BennJo101/Gene_1.0/docs/DESIGN_NOTES.md

> Design notes and history for the Gene head, kept as written while it was designed. File names refer to the
> model sources in `cad/` and scripts in `cad/tools/`; print-ready files are in `print/`. Parts marked retired or
> superseded are described for history only and are not included in this repo.

# Gene head - current build (start here)

Updated 2026-09-25. This section is the current state of the design. The
sections below it are the design history in the order it was built; where a
part or number there has since changed, it is marked **Superseded**.

All dimensions mm. Head frame: jaw pivot axis = X, origin on the axis, -Y is the
front (the face), +Z up. The robot faces -Y, so its own left is +X.

## What to print

Everything is in `print/`, oriented and laid out on six plates (each fits
250 x 250). `BOM.md` / `BOM.csv` have the full parts, hardware and electronics list.

| Part | Source file | Qty |
|---|---|---|
| Skull v7 | `skull.stl` (built by `tools/skull_v7.py` from v6) | 1 |
| Jaw v5, hex pockets + bores for the screw-in pins | `jaw.stl` (built by `tools/jaw_screw_pins.py`) | 1 |
| Jaw pivot pin (hex head, bearing pin, D-shaft) | `jaw_pin.stl` | 2 |
| Servo brackets v2 (with battery pads) | `servo_bracket_L.stl`, `servo_bracket_R.stl` | 1 + 1 |
| Jaw drive hub | `jaw_drive_hub.stl` | 2 |
| Eye display carrier v3 (wide top + bottom slots) / retainer | `eye_display_carrier.stl`, `eye_display_retainer.stl` | 2 + 2 |
| Camera bezel (black) / pupil ring (black) | `camera_bezel.stl`, `pupil_ring.stl` | 2 + 2 |
| Pi 5 shelf v6 | `pi_shelf.stl` | 1 |
| Battery tray / deck | `battery_tray.stl`, `battery_deck.stl` | 1 + 1 |
| Crown insert | `crown_insert.stl` | 1 |
| Bridge handle (optional) | `bridge_handle.stl` | 1 |
| GPIO flashlight (optional, instead of the handle) | `gpio_flashlight.stl` | 1 |
| GPIO cover (optional, for when nothing is plugged in) | `gpio_cover.stl` | 1 |
| Neck / neck base / clamp collar | `neck.stl`, `neck_base.stl`, `neck_collar.stl` | 1 each |

Retired, do not print: `GeneTop_v6_neck` (v7 is v6 + clearances), `GeneTop_v3_*`, `GeneTop_v4_camslots`, `GeneTop_v5_crownbay`,
`GeneBottom_v3_jawdrive`, `GeneHead_xl330_bracket(_R).stl` (v1), `GeneHead_pi_shelf_v4/v5`,
`GeneHead_top_handle.stl` (twist-lock), `GeneTop_v3_barrel_*` (the barrels are in the skull).

## Limits to set in software

| | |
|---|---|
| Jaw speaking range | 0 - 30 deg |
| Jaw servo limit, **neck fitted** | **33 deg** (chin reaches the neck base at 35.5) |
| Jaw servo limit, no neck | 50 deg (first skull contact at 53.25) |
| Twin XL330s | one of the pair **reversed** (Drive Mode bit or negated angle) |
| Neck rotation | no stop (slip ring) |
| Pi 5 on GPIO 5 V | `usb_max_current_enable=1` in `config.txt` |
| Jaw flapping speed, on the neck | up to ~4.4 swings/s of 0-20-0 deg stays within 80 % of servo torque |
| Jaw flapping speed, **head standing on its jaw** (no neck) | **under ~3 swings/s** of 0-20-0 deg; 4/s needs 107 % |
| Talking mouth opening, on the neck | **53 %** of full visemes (~12 deg on "ah", 14 max): servos never max out, 20 % reserve. Yelled ("!") x1.6 -> ~20 deg, brief strain OK |
| Talking mouth opening, head on its jaw | **28 %** (~6 deg on "ah", 7 max), same criterion. Yelled -> ~11 deg at 95 % of available torque |

Weight and servo load (estimate, `tools/mass.py` -> `tools/web/mass.json`, 2026-10-30):
about 1316 g / 2.9 lb as the sim shows it (flashlight, no handle, no neck); skull side
1035 g, jaw + hubs + pins 281 g. Skull CoM 40 mm in front of the pivot and 9 mm above it; jaw
CoM 77 mm in front and 72 mm below. Holding torque against the pair's 1.04 N.m stall:
on the neck 0.21 N.m (20 %) with the jaw shut; standing on the jaw, 0.40 N.m (39 %) just
off closed, easing to 0.19 N.m at 50 deg. Printed parts are estimated from volume + area at
the BOM settings and bought parts from typical weights, so expect +/-15 %: weigh the real head
and rerun. Printing the jaw with 2 walls / 15 % instead of 4 / 22 % cuts it from ~261 to ~162 g.

## Assembly order

1. Eyes: glue the display carriers into the barrels from inside (they are a slip
   fit), fit the displays, glue the retainers behind them (rest each retainer on the LCD, don't press it, or the screen shows pressure marks).
2. Cameras: fit each camera into its black bezel, press the ribbon into the
   slit on the back of the bezel's spoke (no threading - the camera stays on
   its cable) and through the barrel's inboard slot, push the bezel onto the ridge,
   and glue a black pupil ring round the lens. The right bezel is the left one
   turned 180 deg.
3. Battery unit on the bench: pack in the tray (2 straps), deck on (4 x M3x10),
   bucks, BMS and charger on the deck. Lift the whole unit straight up through the
   open bottom of the skull into the dome.
4. Drive: servos onto the v2 brackets (4 x M2x8 each), brackets onto the skull
   walls (2 x M3x16 each, then 2 x M2x16 hex bolts each in from outside the skull,
   M2 nut in the foot's hex pocket). Lower the tray onto the bracket pads, 4 x M3x12 up
   through the pads.
5. Pi: GPIO ribbon's female end onto the header, Pi onto the v6 shelf with the
   header along the front edge (4 x M2.5x12 + nuts). Route the ribbon up in front
   of the battery tray. Drop an M2 nut into the slot in each of the shelf's 4 cubes, push the shelf up into the skull with the cubes in the divots until they stop, then 4 x M2x12 hex bolts in from outside the skull.
6. Crown: push the ribbon's male plug up into the crown insert's pocket, drop the
   insert into the slot, 4 x M2x12 hex bolts. With the handle: bridge handle on
   top, 4 x M3x16 socket heads instead.
   Optional, after the crown: either press the GPIO cover into the well (notch to the
   rear), or fit the GPIO flashlight (see *GPIO flashlight and GPIO cover* below).
7. Jaw: slide the bare jaw up from below so the arm bores line up with the skull
   sockets (no flexing the arms). Push each pin (printed in PETG or tougher) in from outside, D-shaft first,
   through the arm and the socket until the hex head seats flush in the arm's hex
   pocket. Hubs onto the D-shafts (grub screws), hubs bolted to the horns (4 x M2x12
   each), then an M3x5 grub screw into the back edge of each arm to lock its pin.
8. Neck: yoke up under the rear rim, 5 x M3x16. Feed the slip ring's rotating
   wires up the tube bore. Bearings into the base, tube into the bearings, collar
   on underneath (M3 set screw), slip ring onto the base floor (3 x M3x8). Base to
   the body with 4 x M4.

## Still open

- Power switch hole in the skull (the USB-C charge port is cut).
- Wiring for the power switch once its hole exists.
- A drive for the neck rotation, and the body/stand the neck base bolts to.
- Assumed sizes to check against real parts: 2.1" round LCDs, eye cameras,
  speakers, the GPIO ribbon's male plug, the slip ring.

## Verified (last full check)

41 parts assembled, 129 neighbouring pairs measured, 15 cable runs routed and checked with exact solid
intersection; no overlaps except seating contacts. The jaw swept 0-60 deg in
0.25-0.5 deg steps against every part. All print files are single watertight
solids on reload.

Interactive sim with every part, the jaw sweep, head turn, eye expressions and
the two camera views: `sim/head_sim.html` (open it in a browser)

---

## v7 skull and v3 camera bezel - sized to the parts bought (2026-10-04)

Built from the Amazon order of 2026-09-30. Scripts: `tools/skull_v7.py`, `tools/cam3_arducam.py`, check with `tools/check_v7.py`.

| Part bought | Real size | Change |
|---|---|---|
| Arducam B0066 mini OV5647 | 8.5 mm head, ~12 mm with the crystal; 6.0 mm flex; rigid 16 x 30 mm 15-pin tail | Barrel ribbon slots 14 x 4 -> **26.5 x 7.5** (Y -114..-87.5, Z +/-3.75). Bezel pocket 8.6 x 8.6 -> **8.6 x 12.4** (grows towards the cable only, lens stays on axis); 3.6 mm mid-depth tunnel -> **6.8 x 2.2 lane from the rear face**, level with the camera board, 5.6 mm lipped mouth from r=16; spoke 7.0 -> 11.5 |
| TekGroAml 2.1" LCD + driver | LCD 56.18 x 59.71 x 2.3, 26.9 mm flex down; **round 57 mm board**, mini-HDMI + micro-USB on the edge opposite the flex | Top window in each barrel mirroring the bottom one (+/-37.5 deg, Y -96 to the barrel end) and a pocket in the skull above it from Y -88 back, up to 54 mm from the eye axis, never closer than 3 mm to the outside (measured min **3.45 mm**) |

Free height above the board's top edge went from ~2 mm to 17-29 mm over the middle of the eye at Y -84,
and 16-40 mm from Y -76 back. The exception is the **outboard** side (more than ~8 mm out from the eye
axis, in front of Y -76), where the barrel itself is the outside of the head: that's still ~2 mm. So mount
each driver board far enough back (PCB front face at Y -73 or further, about 19 mm behind the back of the LCD - checked with `mocks/display_driver_board.stl`, 0 overlap) that the
outboard plug clears; the LCD flex is long enough to run straight back rather than folding. With the
flex at the bottom and the board's parts facing back, the HDMI plug sits 6 mm outboard of the axis on the
left eye and the USB 9 mm outboard on the right.

Verified: skull single watertight solid (589.9 cm3); bezels, cameras, carriers, displays, retainers, pupil
rings, shelf, Pi, battery unit, brackets, servos, speakers, amps, TTL vs v7: 0 overlap (insert 7.4 mm3 and
neck 1.4 mm3 are the same seating contacts as v6).

Still assumed: display MOCK is still the old 55.4 x 5.2 shape (the real LCD is thinner, so the retainer
sits ~2.9 mm further forward - it's glued, so that's fine). Note the real LCD is 56.18 +/- 0.15 against the
56.00 display seat - test-fit and ease the seat if it's tight. **Eased to 56.60 on 2026-10-30** (see *Display carrier seat eased*).

**Display carrier v2** (`tools/carrier_topslot.py`): still a separate glued-in cup (the barrels are part of the skull, the carriers are not). It gains a flex slot at the top matching the bottom one (+/-15.75 deg, Y -92.5 to the back face), for the driver board's HDMI/USB side. Original carrier kept as `tools/retired/carrier_v1_before_topslot.stl`.

**Display carrier v3** (same script): both slots widened to +/-74.25 deg (Y -92.55 to the back face), so behind the front lip only two side walls are left, each 31.5 deg wide (the width of the old v2 slot). The front lip ring is untouched and still frames the display. Volume 2.45 cm3, down from 4.7. The retainer now has only the two side walls to glue to. v2 kept as `tools/retired/carrier_v2_before_wide_slots.stl`.

**Display carrier seat eased (2026-10-30)** (`tools/carrier_ease_seat.py`): the screens showed slight pressure marks. The real LCD is 56.18 +/- 0.15 across and the seat was 56.00, so the carrier squeezed the glass round its edge, more so as printed holes come out a little undersize. The seat is now **56.60** from the lip's rear face (Y -94.1) to the back face: 0.21 mm a side on a nominal panel, 0.13 on the largest. The front lip (aperture 53.80, so the panel still overlaps it by 1.2 mm a side) and the OD 60.50 are unchanged, so the screen is framed the same and the carrier still slips into the barrel. Side walls 2.25 -> 1.95 mm, 2.28 cm3. The retainer (OD 55.80) still drops in. When gluing the retainer, rest it on the back of the LCD without pressing: it only has to stop the panel falling back. **The glass is not round** (Tailor Pixels TTC021XRS-02 drawing, the same 56.18 x 59.71 x 2.3 panel): a R28.09 circle plus a flat-ended ledge on the flex side, 31.40 wide, its flat edge 31.62 from the centre. The carrier's top and bottom slots started at Y -92.55, so for the first 1.55 mm of the glass the ledge hit a full ring of wall and the panel couldn't sit flat on the lip. Both slots now run forward to the lip's rear face (Y -94.1), 1.83 cm3. The skull's barrels were also in the way: see *Skull v7 ledge relief*. All behind the lip, so the eyes look the same from outside. `print/parts/09_eye_display_carrier_x2.stl`, Plate 4 and Plate 10 (just the two carriers) regenerated; previous carrier kept as `tools/retired/carrier_v3_before_seat_ease.stl`.

**Skull v7 eye pockets made symmetric (2026-10-06)** (`tools/skull_v7_mirror_eye.py`, run after `skull_v7.py`): the plug pocket above Gene's right eye (-X) had a ragged outboard edge, because v6 has leftover internal weld faces at that barrel/skull crease that confused the skin check. The -X eye region (X -100..-33, Y -109..-49, Z 20..75) is now the exact mirror of the clean +X (left) eye. Still one watertight solid (589.5 cm3), min skin 3.34 mm (right) / 3.41 mm (left), part overlaps unchanged (only the insert/neck/handle seating contacts). The +X side is untouched. Old file kept as `tools/retired/GeneTop_v7_before_eye_mirror.stl`. `print/skull_x1.stl`, `3D print/01_skull_x1.stl`, Plates 1 and 9 and the sim have been regenerated.

**Skull v7 barrel corners sealed (2026-10-06)** (`tools/skull_v7_seal_corners.py`, run after `skull_v7_mirror_eye.py`): the bottom flex window cut through the barrel wall where the lower side wall meets it, leaving a small triangular hole to the outside at the outboard bottom corner of each eye (Y -96 to about -85). The barrel wall is restored there only outboard of the lower wall's inner face (r 83.5 about X 0, Y -48), so the inside of the window is unchanged. +1.39 cm3 (590.9 cm3), one watertight solid, part overlaps and the 0-60 deg jaw sweep unchanged. Previous file kept as `tools/retired/GeneTop_v7_before_corner_seal.stl`.

**Skull v7 barrel ends blended into the skull (2026-10-06)** (`tools/skull_v7_barrel_taper.py`, run after `skull_v7_seal_corners.py`): each eye barrel ended in a flat face at Y -61.5 standing up to 4.5 mm proud of the skull side, with a thin see-through crack along it. The barrel's outer cylinder (r 34.25) now carries on backwards as a cone (0.35 mm radius per mm, about 19 deg) that runs into the skull side, which closes the crack. The cone is trimmed outside the head cavity (r 83.3), outside the bore and out of the top +/-45 deg where the plug pocket is, so nothing changes inside. +2.07 cm3 (592.9 cm3), one watertight solid, part overlaps and the 0-60 deg jaw sweep unchanged. Previous file kept as `tools/retired/GeneTop_v7_before_barrel_taper.stl`.

**Skull v7 inboard barrel walls opened (2026-10-06)** (`tools/skull_v7_open_inboard.py`, run after `skull_v7_barrel_taper.py`): the real TekGroAml driver board (seller's drawing: 57 mm round, 4 x M2.5 at (0,0) (0,33.4) (35,33.4) (38.69,0), mini-HDMI 11.5 wide at (-9.27,22.6) and micro-USB 8.0 wide at (-9.37,7.83), both angled 15 deg and splaying apart, 40-pin FPC connector 26.8 long on the opposite edge) puts the outboard plug of each eye - mini-HDMI on Gene's right, micro-USB on his left - only 8-10 mm from the barrel skin when mounted flex-down. The plan is to turn each LCD + board 180 deg in its barrel (flex up, plugs down; the Pi flips the picture with a standard 180 deg display rotation). To let the LCD ribbon swing past while turning it, the inboard wall of each barrel is removed from the top of the camera ribbon slot (Z +3.43) up to the top window, Y -96 to the barrel end, barrel wall only (r 29.8..34.4); beyond it is open head cavity. The bridge between the eyes and the outboard walls are untouched. -7.6 cm3 (585.4 cm3), one watertight solid. With the boards flipped (mock rotated 180 deg) there is no overlap with the skull, Pi shelf, speakers or anything else; the inboard plug then has about 11-12 mm to the Pi shelf's top plate, the outboard one 12-17 mm to the lower side wall. Previous file kept as `tools/retired/GeneTop_v7_before_open_inboard.stl`.

**Skull v7 USB-C charge port (2026-10-06)** (`tools/skull_v7_usbc_port.py`, run after `skull_v7_open_inboard.py`): the charge port is a Poyiccot USB-C panel-mount extension (B086W2R8Z6): female end with a 25 x 8 flange, 2 x M3 holes 16.6 apart, 34.5 long overall; 30 cm lead to a right-angle male that plugs into the charger board on the deck. It is centred on the back of the head at X 0, Z -14, in the vertical-cylinder part of the wall (r 84.0..91.6 about X 0, Y -48). The flange runs vertical, so it seats along the straight direction of the wall and needs no curved seat. Cuts: a flat seat pocket 8.6 x 25.6 from the inside, leaving 3.0 mm of wall in front of the flange (seat plane Y 40.63); a 7.6 x 13.8 (r 2.5) opening through it, big enough for a max-size USB-C overmold (6.5 x 12.35); and 2 x dia 3.4 M3 holes at Z -14 +/- 8.3, which the opening runs 0.3 mm into (a hairline web there would not print). Fit the flange from inside, then the 2 x M3 from outside into its threads; with the supplied 11 mm screws, 8 mm reaches into the flange. Checks: the yoke screw pilots end at Z -41, 14 mm below the flange; with the connector body modelled straight into the head (`mocks/usbc_panel.stl`: flange 4 thick and body 6.5 x 12 x 18 assumed), it clears every part, the jaw sweep and every routed cable by >= 1.6 mm (Pi buck lead) and seats on the skull with 0 overlap. -1.37 cm3 (584.0 cm3), one watertight solid. `print/parts/01_skull_x1.stl`, Plates 1 and 9 and the sim have been regenerated. Previous file kept as `tools/retired/GeneTop_v7_before_usbc_port.stl`.

**USB-C charge port turned 90 deg (2026-10-08)** (`tools/skull_v7_usbc_port.py` edited, then steps 7 and 8 rerun): the flange's long axis now runs horizontal (along X) instead of vertical, so the 2 x M3 holes sit side by side at X +/-8.3, Z -14, and the opening is 13.8 wide x 7.6 tall. Same centre (X 0, Z -14) and seat plane (Y 40.63). The flat seat now spans 25.6 mm across the curved wall, so the wall in front of the flange is 3.0 mm at the centre, 2.6-2.7 at the screws and 2.1 at the flange ends. Mock turned to match (body 12 x 6.5): 0 overlap with the skull, 7.1 mm to the Pi, clear of the jaw sweep, nearest routed cables 1.76 mm (camera L ribbon) and 1.90 mm (Pi buck lead).

**Superseded 2026-10-16 by the shelf divots below.** **Skull v7 shelf nut posts (2026-10-08)** (`tools/skull_v7_shelf_posts.py`, run after `motor_mount_m2.py`): the Pi shelf's 4 wing holes (dia 2.5 at X +/-62, Y -49 / -21, vertical) opened onto empty cavity, because the wall is 17-22 mm outboard of them, so the M3 self-tappers had nothing to screw into. The skull now has a post above each hole: a block 11 wide (Y) x 6 tall (Z -37..-31) whose flat underside is the wing's top face, running from 5.5 mm inboard of the hole out into the wall (inner wall r 83.7 about X 0, Y -48; the post is fused in up to r 86, and the outer skin at r 91.4 is untouched). Each post has a dia 2.4 hole on the wing hole's axis and a 4.3 AF x 2.0 hex slot (Z -35..-33) open to its inboard face, for an M2 nut slid in sideways. An M2 x 8 socket head goes up from under the wing; the head-to-nut-top grip is 6.6 mm, leaving 1.4 mm past the nut. The wings are unchanged. The TTL interface now rests on the two left post tops (mock raised 6 mm, Z -30.9..-16.3; nearest part the left bracket at 4.6 mm). Checks: nuts 0 overlap with the skull, bolts clear of the skull and shelf, skull overlaps with every part unchanged, jaw and hubs never within 9 mm of the bolt heads over 0-60 deg. The post undersides overhang inside the head, so the skull still needs tree supports there. +6.3 cm3 (589.8 cm3), one watertight solid. `print/parts/01_skull_x1.stl`, Plates 1 and 9 and the sim have been regenerated.

**Skull v7 shelf divots and bracket M3 pilots (2026-10-16)** (`tools/skull_v7_shelf_divots.py` replaces `skull_v7_shelf_posts.py`; pilots added to `tools/motor_mount_m2.py`): the whole shelf drops 13.35 mm so its plate's underside is flush with the skull's bottom rim (Z -53.35; plate Z -53.35..-50.35), which gives the Pi 13.35 mm more headroom (Pi stack top Z -28.75, ~43 mm under the battery tray). The speaker cradles hang 7 mm below the rim (Z -60.35), the two 'buck teeth'; the jaw stays >= 7.7 mm from them over 0-60 deg. The Pi, speaker, amp, TTL and splitter mocks moved down with it (`gpio_mocks.py` SHELF_DROP, `route.py` endpoints). The 4 nut posts come off the skull and move onto the shelf as cubes, fused to the top of each wing (Z -50.35..-44.35, 11 wide round the old wing hole, from 5.5 mm inboard of it out to r 85.95 about X 0, Y -48, i.e. 2.25 mm into the wall; the old wing holes are filled). Each cube slides up into a divot: a groove in the inner wall, 11.6 wide and 2.5 deep (out to r 86.2), open at the bottom rim (Z -53.35) and roofed 0.2 above the cube top. The roof is the stop that sets the shelf height. A 4.3 counterbore from outside (head flush with or just under the skin) and a dia 2.4 clearance run along X at Z -47.35 through the wall into the cube, onto an M2 nut dropped into a slot in the cube's top 3 mm inboard of the wall (flats top and bottom, so it seats on the slot floor on the bolt axis). Head to nut far face 9.7-10.0 mm: **M2 x 12**. Wall left behind each groove 5.2 mm, 2.5-2.9 mm under the counterbores. The posts were removed by cutting their footprint back to the wall's own section at Z -38 (the wall is vertical there; the wall line over Z -38..-30 then matches to 0.03 mm, and the volume returns to the pre-post 583.5 cm3). The skull never had the pilots for the bracket M3 self-tappers (nor did v6); they are now cut too: dia 2.5 along X at Y 20, Z +/-10, from the bracket foot face to 2 mm under the skin, 9.9-10.3 mm into the wall. Checks: the shelf with the Pi, speakers, amp, TTL interface and GPIO splitter on it slides the full 38.8 mm up from fully below the rim to its seat touching nothing (0.5 mm steps, against the skull and everything fitted in steps 1-4); seated, it only touches the skull (cube tops on the divot roofs) and the neck yoke's top face, flush with the plate's underside (0 overlap); skull overlaps with other parts unchanged (insert, neck and handle seating contacts). Skull 582.1 cm3, shelf 48.8 cm3, both one watertight solid. `print/plates/Plate8_changes_2026-10-16.3mf` has the skull, shelf and eye X insert together (267 x 301 mm, for the K2 Plus's 350 mm bed). `print/parts/01`, `03` and Plates 1 and 3 regenerated.

**Skull v7 plate between the eyes cut to a U (2026-10-30)** (`tools/skull_v7_eye_plate_window.py`, run after `skull_v7_shelf_divots.py`): the flat plate joining the inboard walls of the eye barrels (Z 2.5..5.1, 2.6 mm thick, X -27..27, Y -130..-82, 5.8 cm3) carries nothing, and printed rim-down it is a roof 57 mm above the bed with tree supports under all of it. Its middle is now cut out through the free back edge (X -20.3..20.3, Y -123.5 to the back, R 5 corners at the face), leaving a U: a 6 mm strip along each barrel wall and one along the face, so the plate still ties the barrels to each other through the face. There is no bar across the back, which would span 54 mm in the air. -4.12 cm3 (577.9 cm3), one watertight solid; part overlaps unchanged (only the insert/neck/handle seating contacts). A first voxel FEA of the skull front (2 mm grid, fixed at Y -30, 20 N on each barrel's front rim down, inward, backward, and on one barrel only) moved the rims within 4 % with the whole plate removed, so the U keeps more than it needs. The camera ribbons still leave the barrels at Z 0 under the side strips. `print/parts/01_skull_x1.stl`, Plates 1 and 8 and their tree-support copies regenerated. Previous file kept as `tools/retired/GeneTop_v7_before_eye_plate_window.stl`.

**Skull v7 barrel tabs shortened (2026-10-30)** (`tools/skull_v7_shorten_tabs.py`, run after `skull_v7_eye_plate_window.py`): behind the camera ribbon slot (rear edge Y -87.5) each barrel's inboard wall is only a lower arc, from the slot's height down to about Z -25, left over from opening the inboard walls. It ran back to the barrel end at Y -61.4 and carries nothing behind the display carrier (which ends at Y -84.1). Both tabs are now cut back to half that length, ending at Y -74.45 (13 mm behind the slot, 9.6 mm behind the carrier). Only the inboard half of the barrel wall is cut. -3.27 cm3 (574.7 cm3), one watertight solid; part overlaps unchanged. `print/parts/01_skull_x1.stl`, Plates 1 and 8 and their tree-support copies regenerated. Previous file kept as `tools/retired/GeneTop_v7_before_shorten_tabs.stl`.

**Skull v7 ledge relief (2026-10-30)** (`tools/skull_v7_ledge_relief.py`, run after `skull_v7_shorten_tabs.py`): mounted ribbon up, the LCD's ledge sits at Y -94.1..-91.8 and spans +/-34 deg about the top of the barrel, where the outboard barrel wall (bore r 30.3, outside r 34.4) was solid. On that side the barrel's outside *is* the head's skin, and with a plain rectangle for the ledge its corners reach r 35.3, outside the skin, so a full-depth clearance can't be cut (a first attempt opened the skin above both barrels and was reverted). The ledge outline +0.4 is cut into the wall only out to r 33.2, from Y -94.5 to the barrel end, leaving about 1.1 mm of wall under the skin (measured 1.02-1.05 on rays from the relief face). Checked from outside with rays from 13 directions: no change at all. The rectangle outline still overlaps that last wall by 10.7 mm3 per eye (was 86), at its corners; the real ledge is rounder (the screens went in ribbon-up), so it should now sit free. Turning the screens to clear it was ruled out: with the driver board turned with them by 30-50 deg the board and plugs hit the skull by 380-600 mm3, and the 26.9 mm flex can't reach a board left where it is. -0.67 cm3 (574.0 cm3), one watertight solid; part overlaps unchanged. `print/parts/01_skull_x1.stl`, Plates 1 and 8 and their tree-support copies regenerated. Previous file kept as `tools/retired/GeneTop_v7_before_ledge_relief.stl`.

**Eye X insert (2026-10-16, optional)** (`tools/eye_x_insert.py`): a Halloween cap for an eye barrel. A solid dia 58.70 x 6 plug goes into the dia 59.00 front bore (the bezel is 38 mm further in), a dia 66 x 2 flange (0.8 chamfer) sits on the barrel's front face at Y -137.6, inside the barrel's 68.5 outline, and a raised X stands 3 mm proud: two 52 x 8 round-ended bars at +/-45 deg. Symmetric, so it fits either eye; 0 overlap with the skull in both, seated on the face. 25.2 cm3, 11 mm tall printed plug down. `cad/eye_x_insert.stl` (barrel frame) and `print/parts/20_eye_x_insert_OPTIONAL_x1.stl`. Not on a plate.

**Servo brackets through-bolted with M2 (2026-10-06)** (`tools/motor_mount_m2.py`, run after `skull_v7_usbc_port.py`): each bracket's foot (its rear end, cut conformal to the inside of the skull wall, inner face the plane X -/+43) now also takes 2 x M2 socket-head bolts through the skull wall, alongside the 2 x M3 self-tappers (Y +20, Z +/-10). Bolts at Y 19, Z +/-4.5, along X like the M3s: dia 2.4 clearance through the wall and foot, a dia 4.3 counterbore from outside whose floor sits 2.2 mm under the shallowest point of the skin round it (so the 2.0 mm head ends up flush or just under the skin; the skin is slanted there, so the counterbore is up to ~3 mm deep on its forward side), and a 4.3 AF x 2.2 hex pocket in the foot's inner face for an M2 nut. Grip from the head to the far face of the seated nut is 13.8-14.3 mm, so **M2 x 16** leaves ~2 mm past the nut, ending 1-1.5 mm inboard of the foot face (open space; the servos end at Y 9.5). The foot is 7.6 mm thick at the bolts, leaving 5.4 mm behind each nut; nut corners are 1.5 mm from the M3 holes. Skull 583.6 cm3, brackets 6.84 cm3 each, all single watertight solids; the assembly check shows no new overlaps and the bracket gaps are unchanged. `print/parts/01`, `06`, `07`, Plates 1, 4 and 9 and the sim have been regenerated. Previous files kept as `tools/retired/GeneTop_v7_before_m2_bolts.stl` and `GeneHead_xl330_bracket(_R)_v2_before_m2_bolts.stl`.

**Jaw pivot-screw holes filled (2026-10-06)** (`tools/jaw_fill_pivot_holes.py`): each jaw arm had a stepped blind hole on the pivot axis, opening on the outboard face (dia ~5.4 for 14 mm, then dia ~2.9 down to the start of the D-shaft, 30.4 mm deep in all). It was for a screw through the pivot. The pins are now D-shafts clamped by the drive hubs and nothing screws into the jaw, so both holes are filled solid, flush with the arm faces. +0.81 cm3 (408.3 cm3), one watertight solid, outer shape and bounds unchanged, so fits and the jaw sweep are unaffected. `print/parts/02_jaw_x1.stl`, Plate 2 and the sim have been regenerated. Previous file kept as `tools/retired/GeneBottom_v4_before_hole_fill.stl`.

**Jaw v5: screw-in pivot pins (2026-10-29)** (`tools/jaw_screw_pins.py`): on v4 each arm carried its dia 13.74 bearing pin and dia 8 D-shaft as one piece, 42 mm out from the arm's inner face, and the pin had to pass axially through the closed ring of the skull socket (full circle over X -/+78..73). Fitting the jaw meant springing the arms ~32 mm apart each side, and the pins snapped. The pins are now separate parts, `jaw_pin.stl` x 2 (the right one is the left turned 180 deg about Z, as with the hubs):
- **Pin:** hex head AF 15 x 5.9, then the v4 bearing pin (dia 13.74) and D-shaft (dia 8, flat at Z +3, ends at X -/+46), taken from the v4 mesh unchanged inboard of X -/+78. 53 mm long, 5.5 cm3. Print hex head down, 100 % infill, in a tough filament: PETG at least, nylon (PA / PA-CF) or PC if your printer can do it, not PLA.
- **Arm:** hex pocket AF 15.3 x 6.0 deep in the outboard face (0.15 clearance per flat; 2.0 mm of wall left at the pocket corners, the arm face is r >= 10.9 round the axis), then a dia 14.1 bore through the rest of the arm. The step under the head seats on the pocket floor, so the pin is located inboard; the hex carries the servo torque into the jaw.
- **Lock:** an M3 x 5 grub screw (the hub size), radial along +Y from the back edge of each arm, 3 mm in from the outboard face, into a 3.2 wide groove round the hex head (root r 5.8, so the grub ends flush with the arm edge). The line is clear of every other part for a hex key.
- **Assembly:** without the pins, the jaw slides straight up onto the skull from below with no contact at any point of the path (checked by translating it 0-25 mm in 30 deg steps round the axis: straight down and 30 deg behind it are both clear). Then each pin goes in from outside, through the arm and the socket into the hub.

Checked: jaw 396.45 cm3 and pins single watertight solids (also on reload); pin-to-jaw gap 0.05 (L) / 0.10 (R) mm, pin-to-socket 0.37 mm, the same running fit as v4. Every other contact in the static check is unchanged (the D-shaft-to-hub and horn contacts have moved from the jaw to the pins), and so is the sweep: first skull contact 53.25 deg, neck base 35.5 deg. `print/parts/02_jaw_x1.stl`, the new `23_jaw_pin_x2.stl`, Plate 2 (jaw + 2 pins, 198 x 186 mm) and both sims have been regenerated. Previous jaw kept as `tools/retired/jaw_v4_before_screw_pins.stl`.

---

# Design history

## Jaw drive (XL330-M288-T), first version

**Superseded:** this section describes the single-servo v3 drive. The build now uses
the twin drive (jaw v4, v2 brackets) - see *Twin motors* and the current build above.

All dimensions mm. Reference frame: pivot axis = X, origin on the axis,
+X inboard (toward head centre), left side is -X. The drive is on the LEFT.
Jaw rest angle = 0 deg in this frame.

## Parts

| File | What | Print |
|---|---|---|
| `GeneBottom_v3_jawdrive.stl` | The jaw, with the left pivot pin extended into a dia 8.0 D-shaft | 1 |
| `jaw_drive_hub.stl` | Drive hub: dia 18 OD x 15 long, D-bore, 4 x M2 on dia 12 to the horn, radial M3 grub | 1 |
| `GeneHead_xl330_bracket.stl` | Servo bracket, 4 x M2 to the servo, 2 x M3 into the skull wall | 1 |
| `GeneTop_v3_thrustpad.stl` | The skull, with a conformal thrust pad added at each pivot | 1 |
| `GeneHead_jawdrive_assembly.stl` | Whole thing assembled, for viewing only | - |
| `render_jaw_drive.png` | Hub, bracket, and the drive train | - |

Hardware: 4 x M2 x 12 (hub to horn), 4 x M2 x 8 (servo to bracket),
2 x M3 x 16 self-tapping (bracket to skull), 1 x M3 grub (hub to shaft).

## How it goes together

1. Jaw pin passes outside-in through the skull socket as before. The new
   dia 8.0 D-shaft continues past the socket into the head.
2. Hub slides onto the D-shaft, flat-to-flat, grub screw from the side.
3. Servo bolts to the bracket (4 x M2), horn facing outboard.
4. Bracket screws to the skull's inner wall (2 x M3 at Y=+20, Z=+/-10).
   The bracket foot was cut with a boolean against the skull, so it is an
   exact conformal match to the inner surface, not a flat pad on a sphere.
5. Hub bolts to the horn, 4 x M2 on the dia 12 bolt circle.

## Verified numerically

- Every part watertight and a single body.
- Zero interference: hub/servo/jaw vs skull and bracket, 0 of 8000 sample
  points in all six pairings.
- Bracket vs skull max penetration 0.0000 mm (conformal by construction).
- Bracket screws pass through 8 mm of bracket into 11 mm of skull wall
  (wall measures 7.5-11 mm thick all round the pivot).
- Jaw sweep clear 0-53 deg; first contact (left arm) at 53.25 deg, right arm at 57.25 deg.
  Set the servo limit to 50 deg or less - **or 33 deg with the neck fitted**.
- Axial play 8.5 mm bare -> 4.75 mm with the hub -> **0.30 mm** with the
  thrust pads (free range dx -0.10 .. +0.20).
- Thrust pads: annulus r 7.30-11.00 at each pivot, shaped as the complement
  of the jaw's swept volume over -5..60 deg with 0.10 mm clearance, so the
  pad face matches the jaw arm exactly instead of being a flat ring on a
  curved shell. Both pads fuse into the skull body (body count stays 4).
- Skull + pads re-welded after export: watertight, 4 bodies, 603.9 cm3.

## Known limits

- A pivot sleeve and a thrust washer were both tried and dropped: measured
  on the real faceted meshes, the socket's usable bore is dia 14.28 and the
  pin is dia 13.76, leaving 0.26 mm radial - no room for a sleeve, and the
  annulus at the socket mouth is already occupied by skull material.
  The bare pivot fit is 0.52 mm diametral, which is a workable running fit.
- The socket still only wraps the pin over ~56% of its circumference.
- Horn screws: the ROBOTIS STEP models the horn holes at dia 1.60. The hub
  is drilled dia 2.20 for M2. Check your actual horn before final print.
- The right-hand pivot is undriven and runs as a plain bearing, but it does
  get a thrust pad, so both sides locate axially.
- The pads are cut for the jaw travelling -5 to 60 deg. Widening the travel
  later means recutting them.
- **Superseded:** print the skull from `skull.stl` (it contains these thrust pads).

---

# Eye displays (2.1 inch round)

Measured bore of each eye barrel, along its axis from the front face:

| Depth | Diameter | Role |
|---|---|---|
| 0 - 38 mm | 59.00 | front tube |
| 38 - 40 mm | **56.80** | the inner circle - the ridge you see down the barrel |
| 40 mm - rear | 60.60 | rear cavity, opens into the head |

The monitor loads from **inside the head** and seats against the rear face
of the 56.80 ridge, so the ridge frames the screen.

| File | What | Print |
|---|---|---|
| `eye_display_carrier.stl` | Cup, OD 60.50 x 12 long. Aperture 53.80, pocket 56.00 x 10.0 (**56.60 since 2026-10-30**), cable slot at the bottom | 2 |
| `eye_display_retainer.stl` | Ring OD 55.80 ID 46.0 x 3.0, traps the module in the cup | 2 |
| `mocks/display.stl` | The module itself, for fit checking only - do not print | - |

Verified: carrier and module clear both barrels and the skull, 0 of 6000
sample points in every pairing. Active area clears the ridge by 1.73 mm all
round and the carrier lip by 0.23 mm.

**Module dimensions are assumed** - active area dia 53.34 (2.1 in) with a
55.4 mm body. Real 2.1 in round LCD modules vary. The two numbers to change
for your part are the pocket diameter (56.00) and pocket depth (10.0) in
`eyebuild.py`; everything else follows.

The carrier is a slip fit, not an interference fit: 0.106-0.109 mm radial
clearance to the bore at its tightest (full-assembly check). Glue it with CA;
the ridge takes the forward load. Glue the retainer too - nothing holds it axially.

---

# Pi 5, speakers, and eye cameras

## Where things fit

The cavity is 2721 cm3, but two things constrain it: the eye barrels pinch
the front to a **46 mm channel** between them, and the XL330 sits mid-cavity
at X -46..-17, Y -24.5..9.5, Z -10..10. An 85 mm Pi 5 cannot go where the
original shelf was.

The barrels bottom out at Z -34.67 and the cavity floor is at Z -53. That
band runs the full width of the head, so the shelf passes *under* the eyes.

| File | What | Print |
|---|---|---|
| `GeneHead_pi_shelf_v5.stl` | **Superseded by v6** (4 mm standoffs). Shelf, plate Z -40..-37, 92 x 108 with conformal side wings, Pi 5 standoffs, 2 speaker cradles, cable slot | 1 |
| `mocks/pi5.stl` | Pi 5 board + 14 mm component stack, fit check only | - |
| `mocks/speakers.stl` | 2 x dia 28 x 5 speakers, fit check only | - |

Pi 5 sits on standoffs (6 mm in v5, **4 mm in v6**), holes 58 x 49, board centred at (0, -29).
In the current build the board is turned so its GPIO header runs along the front edge.
Speakers drop into dia 28.4 cradles at (+/-26, -88) facing down, each with a
dia 23 sound hole through the plate. The wings were cut against the skull so they
match the curved inner wall exactly. Cubes on the wings slide up into 4 divots in the skull wall and bolt in from outside
with M2 x 12 (see *Skull v7 shelf divots*). The original 4 x M3 self-tappers had nothing to bite:
the wing holes are 17-22 mm inboard of the wall.

Verified clearances:

| | |
|---|---|
| Pi 5 component top to servo underside | 5.4 mm (v5); **7.4 mm with the v6 shelf** |
| Shelf top to eye barrel underside | 2.33 mm (15.7 mm since the 2026-10-16 shelf drop) |
| Headroom under the shelf | 18.5 mm |
| Speaker underside to cavity floor | 6 mm |
| Shelf / Pi / speakers vs shell, servo, bracket, hub, carriers | 0 of 8000 pts |
| Jaw sweep 0-55 deg vs shelf | clear |

## Eye cameras

A micro camera sits at the centre of each eye, in front of the display, so
it reads as the pupil. Its ribbon leaves through a slot cut in the **inboard**
wall of each barrel and into the central channel between the eyes - the
display is never crossed by the cable.

| File | What | Print |
|---|---|---|
| `GeneTop_v4_camslots.stl` | Skull with thrust pads **and** the two 14 x 4 mm ribbon slots. **Superseded by v6**, which keeps these slots | 1 |
| `camera_bezel.stl` | Print in black. Bezel OD 58.6 x 6, **one spoke**, 8.6 mm square camera pocket, dia 7.5 lens aperture, cable channel open to the rear face (slit) so the ribbon drops in with the camera attached. Rotate 180 deg about the barrel axis for the second eye | 2 |
| `mocks/camera.stl` | 8.5 mm camera + lens barrel, fit check only | - |

The bezel slips into the dia 59.00 front bore and seats on the front face of
the dia 56.80 ridge, 38 mm down the barrel.

**Single spoke.** The bezel has one arm, not three, and it points inboard
straight at the ribbon slot. The cable runs *inside* it in a 3.6 mm channel
that opens to the rear face through a 2.6 mm slit with 0.5 x 0.8 mm retaining
lips (added 2026-09-27, because the camera
module can't be unplugged from its ribbon to thread a closed tunnel) - walls
1.70 mm either side, 2.10 mm in front - so no cable is visible from the front and only one arm crosses the display.
Because the spoke has to point inboard on both sides the part is handed, but
rotating it 180 deg about the barrel axis hands it the other way: one file,
printed twice, same trick as the drive hub.

Verified: spoke points +X on the left eye and -X on the right (both inboard),
tunnel hollow at its centre with solid spoke around it, and the exit line
through the barrel slot is clear on both sides. Camera and bezel clear the shell
and the display carrier, 0 of 3000 points each, both sides. Both ribbon slots
probe fully open.

**Camera module is assumed** at 8.5 mm square with a 6 mm lens barrel (the
common OV5647 / IMX219 mini modules). Change `CAM` and `LENS` in `cam.py` for
a different part.

## Print list at this stage

**Superseded** - see *What to print* at the top of this file.

---

# Twin motors

Two XL330-M288-T, one per pivot, in tandem: **1.04 N.m** combined stall
torque at 5 V (0.52 each).

| File | What | Print |
|---|---|---|
| `jaw.stl` | Jaw with **both** pins extended into dia 8 D-shafts. Use this, not v3 | 1 |
| `GeneHead_xl330_bracket.stl` | Left bracket (**superseded by** `servo_bracket_L.stl`, which adds the battery pads) | 1 |
| `GeneHead_xl330_bracket_R.stl` | Right bracket (**superseded by** `servo_bracket_R.stl`) | 1 |
| `jaw_drive_hub.stl` | Hub - the right one is the SAME part rotated 180 deg about Z | 2 |

The right side was probed before being trusted rather than assumed
symmetric: shell measures 12.0 mm thick at the anchor on both sides, and
the right pin geometry mirrors the left. The right bracket is the left's
construction mirrored in X and then re-cut against the actual right-hand
skull; it came out at 6.45 cm3, identical to the left.

Rotating the hub 180 deg about Z puts its counterbores outboard on the right
while leaving the D-flat on the same face, so one hub file serves both sides.

Verified: servo R, hub R and jaw v4 all 0/4000 against the shell; bracket R
penetration into the skull 0.0000 mm (conformal, by construction); right
pilots pass through 8 mm of bracket into ~12 mm of shell; jaw sweep clear
to 53 deg with both drives fitted (the later full-assembly check refined 55 to 53).

## Wiring - important

The two servos face opposite directions, so one jaw motion turns them in
**opposite senses**. Invert one of the pair, either with the Drive Mode
reverse bit in its control table or a negated angle in software. Sending
both the same command makes them fight each other and stall.

## Travel

| | |
|---|---|
| Speaking range | **0 - 30 deg** |
| Mechanical limit | 53 deg (skull); **35.5 deg with the neck** - set 50 / 33 |

The viewer's Cycle button now animates 0-30 deg only; the slider still
reaches 55 so the limit stays visible. The remaining travel is headroom,
not working range.

Hardware, doubled on the drive: 8 x M2x12 hub to horn, 8 x M2x8 servo to
bracket, 4 x M3x16 self-tapping bracket to shell, 2 x M3 grub hub to shaft.

---

# Top carry handle (retired)

**Superseded:** the crown slot is now filled by the crown insert, and the optional
bridge handle bolts on top of it. Do not print `GeneHead_top_handle.stl`. Kept here
for the slot measurements.

The crown slot measures **26.5 mm wide** (X -12.0 .. +14.5, centred X=+1.25,
so it is 1.25 mm off the dome's centreline) and runs about 100 mm fore-aft
through a shell 7.0-7.5 mm thick. The rim is flattest over Y -58 .. -38
(top Z 89.5-90.0, underside 82.0-82.5); the handle seats there, centred
at Y = -48.

**Quarter-turn twist lock.** Drop it in with the foot aligned along the
slot, turn 90 degrees, done. No flexing legs, no screws, no reaching inside
the head. To remove, turn back and lift.

| Feature | Value |
|---|---|
| Foot | 34 x 22 x 4, obround, top face at Z 80.80 |
| Insert clearance | 2.25 mm each side of the 22 mm foot in the 26.5 slot |
| Locked overhang | 3.75 mm onto the rim each side |
| Stem | dia 20, turns freely in the 26.5 slot |
| Shoulder underside | Z 90.70 (rim high points measure 90.47) |
| Grip | cross bar 90 long, 45 mm above the rim, 28 mm finger gap |
| Detents | 2 x dia 5 x 1.0 on the foot top, engage only in the last ~10 deg |

Verified: 0.000 mm interference at every step of the turn from 90 to 10
degrees, 0.096 mm at locked - that last figure is the detent bumps, which
is the click.

The foot sits 1.6-2.0 mm below the rim underside, so the handle lifts that
far before taking load. Deliberate, to keep the turn easy.

The foot is obround rather than rectangular so it has no corners to catch
the dome's curved underside as it sweeps.

---

# Full-assembly fit check (2026-09-25)

All 25 parts at that stage placed together, 88 neighbouring pairs measured with exact solid
intersection (Manifold), jaw + hubs swept 0-60 deg in 0.25-0.5 deg steps.
Servos checked as a solid envelope (the STEP mesh is not watertight).

- **No clashes anywhere in the 0-30 deg speaking range.**
- First jaw-to-skull contact at **53.25 deg** (left arm), not 55. Limit the servo to <= 50 deg
  (33 deg once the neck is fitted).
- **Fixed:** `camera_bezel.stl` had its camera pocket cut flush with
  the rear face, leaving a zero-thickness skin that some kernels/slicers fill in.
  Pocket now runs 1 mm through; geometry and volume (5.03 cm3) unchanged,
  camera clears by 0.05 mm. Re-slice this part.
- **Fixed:** Pi standoffs 6 -> 4 mm (`pi_shelf.stl`). Pi mock now includes a
  16 mm USB/Ethernet block overhanging the board edge 2.5 mm; clears the bracket by 1.4 mm.
- **Fixed (handle since retired):** handle -X detent 1.00 -> 1.35 mm. That rim is nearly flat, so 1.45 would rub
  through the whole turn; 1.35 stays clear until the last ~15 deg and seats 0.12 mm
  (+X seats 0.22). Both sides click.
- **Check:** display carriers and retainers are slip fits - glue both.
- By design: D-shaft ends sit flush on the horn faces at X +/-46 (turn together);
  jaw to thrust pads 0.08 mm at rest; hub to skull 0.40, hub to bracket 0.50.

---

# Battery (2S2P 18650)

Budget at 5 V: Pi 5 + cameras 7.5 W typ / 12.5 peak, 2 x XL330 3 / 14.7 (stall
1.47 A each), 2 LCDs 1.2, audio 1 / 4. From the pack at 90 % conversion:
**~14 W talking, ~36 W peak**. 2S2P 18650 (3000-3500 mAh, >=10 A cells such as
Samsung 30Q or Molicel P28A) = 43-50 Wh -> **about 3 h**. Peak 6.2 A at 6.4 V.
2S 20 A balancing BMS (HW-391), on the deck. Two 5 V 5 A bucks: Pi rail (5.1 V) and servo+audio rail.

| File | What | Print |
|---|---|---|
| `battery_tray.stl` | Tub, 3 cradle ribs, 2 strap windows (22 mm hook-and-loop), rear lead exit, trimmed >=1.4 mm off the dome | 1 |
| `battery_deck.stl` | Lid plate: 2 x 26.4x26.4 buck bays (Pololu D36V50F5) + 49x21 BMS bay (HW-391) + 40x20 charger bay, zip-tie slots, lead hole | 1 |
| `servo_bracket_L.stl` / `_R_v2.stl` | Brackets with 2 screw pads on top. **Use these instead of the v1 brackets** | 1 each |
| `pi_shelf.stl` | Shelf with 4 mm standoffs. **Use instead of v5** | 1 |
| `mocks/battery_2S2P.stl`, `mocks/power_boards.stl` | Fit check only | - |

Pack sits in the dome over the servos: tray X -45..45, Y -58.5..19, Z 14..38.5;
deck to Z 42.5, boards to ~51. Tray floor rests on the bracket pads (Z 14).

**Fit order:** pack + tray + deck + boards as one bench unit -> lift straight up
through the open skull bottom into the dome (checked, no contact) -> fit both
brackets with servos -> lower tray onto pads -> 4 x M3x12 self-tappers up through
the pads (at X +/-41.5, Y -31 and +14) -> Pi shelf -> crown insert -> jaw -> neck. Deck screws 4 x M3x10
from above into the tray posts (X +/-41.5 Y -54.5, X +/-20 Y 15.5).

Verified: tray, deck, pack and boards clear everything else (skull >= 1.4 mm,
eye barrels 2.9 mm); jaw sweep unchanged.

The pack is meant to stay in the head; it charges through the USB-C port in the lower back of the skull (see *Skull v7 USB-C charge port*).

---

# Camera pupils

`pupil_ring.stl` (print 2, black): OD 18 x 2 mm, glued to the front face
of each bezel hub. Bore is a 60 deg cone from dia 7.5 at the face to 14.4 at the
lip, so the lens reads as a deep pupil. Clear field of view from the lens: 153 deg
(no vignetting for any normal lens); lens clears the bore by 0.75 mm. Print the
bezels black as well, so the ribbon spoke vanishes against the dark screen.

Screen graphics treat the lens as the fixed pupil: an aperture-blade iris around
it opens and closes per expression; gaze turns the focus ring and nudges the lids
rather than moving the pupil off the lens.

---

# GPIO flashlight and GPIO cover (optional)

Built by `tools/gpio_flashlight.py` (run with cwd = tools). Both use the crown insert's
GPIO well (pins in a 52.2 x 6.4 well centred X 1.25, Y -46.5; pin tips Z 85.5).

| File | What | Print |
|---|---|---|
| `gpio_flashlight.stl` | Saddle on the crown insert (X -13.5..16, Y -99..-12), a strap 14 wide over the brow, and a lamp pod dia 27 centred X 0, Z 40 on the forehead, pointing straight ahead (-Y). Front of the pod at Y -155 | 1, PETG |
| `gpio_cover.stl` | Flush plug for the well: skirts straddle the pins on all four sides, 4 crush ribs, pry notch at the rear end | 1 |
| `mocks/gpio_header.stl` | The flashlight's 2x20 female header, fit check only | - |

**Flashlight mount.** A standard 2x20 female header (8.5 mm body) goes upside down onto
the crown pins and sits on the ribbon plug's body (Z 79.5..88.0). The crown bulges up to
3 mm above the header in the middle of the well, so the saddle has a tongue (6.0 wide in
the 6.4 well) that reaches down to the header's top with a 0.3 mm glue gap. The header's
solder tails point up into a 4 mm cavity in the tongue. A 4 x 2.5 mm channel under the
strap carries 3 wires from there to a 16 dia x 7 mm driver cavity behind the LED star.
The pod has a 20.4 mm bore, 14.5 deep, for a 20 mm optic in front of a 20 mm star, and
the star sits on the step into the cavity.

The saddle is screwed down through the front pair of crown screw holes with
**M3x20 socket heads** instead of the M2x12 hex bolts (7.3 mm under the head, 6.8 mm of
thread in the ledge + boss, which have 8.2). That keeps knocks off the pins. It also
means the flashlight and the bridge handle are either/or. The rear pair stay M2x12
hex bolts; the saddle ends 2.5 mm short of their heads. The underside follows the real
crown and brow with 0.2 mm clearance. The strap's top is smoothed where the dome dips in
front of the slot. Nothing is inside either camera's 62 x 49 deg view.

Fitting: solder the 3 wires to the header's tails first, then push the header onto the
crown pins on its own. Put a bead of CA or epoxy on its top, lay the wires in the channel,
lower the saddle onto it and screw it down. Leave it to cure in place so the header sets
exactly where the pins want it.

**Electrics.** It uses 3 pins: 5 V, GND and GPIO 12 (PWM0, pin 32; not used by the I2S
amps). The circuit: 5 V -> LED -> 10 ohm 1 W -> AO3400A drain, source to GND; gate from
GPIO 12 through 100 ohm, with 10 k to GND. That gives about 200 mA (0.6 W in the LED,
0.4 W in the resistor, 60-70 lm). Through a 30 deg optic that's roughly 250 lux at 1 m,
against about 2 lux from both eye screens at full white. Dim it with PWM, e.g.
`gpiozero.PWMLED(12)`. **Which crown pin is which depends on how the ribbon was folded
under the crown**, so find 5 V and GND with a meter on the powered head before soldering.

**Cover.** 6.2 x 51.9 mm, top trimmed flush to the crown. Its skirts (1.1-1.4 mm) go down
either side of the pins, clearing the real pin field (rows at +/-1.27, 0.64 square) by
0.35 mm, and stop 0.6 mm above the ribbon plug. Four 1 mm crush ribs give 0.1 mm
interference per side. The notch at the rear end (Y -20.5) takes a fingernail or a small
flat screwdriver.

Verified: the flashlight clears the skull by 0.20 mm, the insert by 0.20, the ribbon plug
by 2.05 and its header by 0.30. The cover clears the real pins by 0.35. Both are single
watertight solids and reload watertight. The pair check lists handle x flashlight and
cover x flashlight/header as overlaps, but those are alternatives, not a fit.

---

# Crown feature bay (replaces the twist-lock handle)

The top slot (measured: vertical walls at X -12.26 / +14.76, 27.0 wide, Y -105.2..+9.7
with shallow arced ends) is now a feature bay.

| File | What | Print |
|---|---|---|
| `GeneTop_v5_crownbay.stl` | Skull v4 + a 4 mm x 3 mm ledge round the underside of the slot + 4 screw bosses (dia 7 x 6, M3 pilots). **Superseded by v6**, which keeps the ledge | 1 |
| `crown_insert.stl` | Fills the slot flush (top built from the real rim heights both sides + across-slot curvature), sits on the ledge, 4 x M2x12 hex bolts from above | 1 |
| `bridge_handle.stl` | Optional. Two feet conformal to the insert, 16 mm grip 25 mm above the crown, M3x16 socket heads through bores in the posts | 1 |
| `mocks/gpio_plug.stl` | Male IDC plug of the ribbon, fit check only | - |

Screw positions (X,Y): (-10.26,-90) (12.76,-90) (-10.26,-6) (12.76,-6). Insert over the
ledge 5.9 mm; 8.2 mm of thread engagement in ledge + boss.

**GPIO riser:** 40-pin female-to-male extension ribbon (20 cm). Female end on the Pi
header; the male IDC plug (assumed body 56 x 8.9 x 7.6, pins 6 mm) pushes up into a
pocket in the insert, centred Y -46.5, pins in a 52.2 x 6.4 well with tips 1 mm below
the lowest surface over the well. Add-ons plug in from the top with a 2x20 female header.
The Pi is now mounted with its GPIO along the FRONT edge (USB/Ethernet at -X). Ribbon
route: forward off the header, straight up in front of the battery tray (X +/-25.5,
Y -61..-59.6; 1.1 mm to the tray, 1.2 mm to the eye barrels), twisted on edge under the
crown into the plug. Checked clear all the way.

Verified: insert and handle clear everything (seating contacts only, 13 um and 5 um),
all new parts single watertight bodies.

The old `GeneHead_top_handle.stl` (twist-lock) is retired.

---

# Neck on a slip ring

The skull's lower section is a vertical cylinder wall (r 84.0..91.5 about X 0, Y -48,
bottom face Z -53.35). The neck axis is X 0, Y +20, just behind the hinge.

| File | What | Print |
|---|---|---|
| `GeneTop_v6_neck.stl` | Skull v5 + 5 M3 pilots up into the rear rim. Superseded by v7 (`skull.stl`) | 1 |
| `neck.stl` | Yoke under the rear rim (5 x M3x16 up into the wall) + tube OD 44, bore 26 (cable hole), stepping to OD 40 for the bearings | 1 |
| `neck_base.stl` | Bearing housing: 2 x 6808 (40x52x7) 20 mm apart, slip-ring floor, D-shaped flange with 4 x M4 on a 76 x 45 rectangle | 1 |
| `neck_collar.stl` | Clamps under the bottom bearing (M3 set screw + captive nut) | 1 |
| `mocks/neck_bearings.stl`, `mocks/slip_ring.stl` | Fit check only | - |

Load path: head weight -> tube step -> top bearing inner race -> housing. The collar
stops lift-off. The slip ring (assumed: 22 mm body, 30 mm tall, 44 mm flange, 3 holes on
PCD 35) bolts to the base floor and reaches up into the tube bore; fixed wires leave
through the 12 mm hole in the floor, rotating wires run up the bore into the head.

**Jaw limit with the neck fitted: 33 deg.** The chin swings back under the head as the
mouth opens; it clears the neck by 12 mm at 30 deg and first touches the front of the
base at 35.5 deg (the base flange is flat at the front to get that far).

---

# Sim additions (no printed parts)

- Eye screens: nine expressions (neutral, happy, sad, angry, surprised, sleepy,
  love, wink, loading), blink and look-around. The lens is always the pupil; an
  aperture-blade iris surrounds it. Baseline colour is green (hue 140). Loading
  spins the blades, chases a string of dots round the iris and fills a progress
  arc that restarts.
- Camera POV: live views from both lens positions (62 x 49 deg, IMX219-class),
  stereo baseline 121.9 mm, shown as a stereo pair with the robot's own left eye
  on the left. The lenses sit 31.5 mm inside the barrels (bore 59), so anything
  wider than ~86 deg horizontal would see the barrel wall.
- Head turn on the neck, with a Spin control.

---

# Wiring (all runs routed and checked)

Script: `tools/occ_all.py` builds a 2 mm occupancy grid of the whole assembly (fixed
parts + the jaw's 0-35 deg sweep; column ray-fill, ~20 s), `tools/route.py` routes each
cable (Dijkstra on the free grid, radius + 2 mm margin, string-pulled), adds it as an
obstacle for the next, then rebuilds every cable as a solid tube and intersects it
exactly with every part and every other cable (ends trimmed 6 mm where they plug in).
Results in `tools/cables.json`; lengths to buy are in `BOM.md` section 5.

All 14 runs plus the GPIO ribbon fit. Tightest: left display cable 0.19 mm, pack leads
0.25 mm (both at the full 6 mm envelope). The right camera ribbon wraps behind the Pi
shelf's rear edge and just touches it.

Added so the wiring works:
- `mocks/gpio_splitter.stl`: 1-to-2 GPIO splitter on the Pi header. The crown
  ribbon's plug moves up 12 mm onto it; the amps use the second header.
- `mocks/ttl_interface.stl`: DYNAMIXEL TTL interface resting on the two left shelf cubes (Z -44.25..-29.65 since the shelf drop).
- `mocks/i2s_amp.stl`: one MAX98357A amp centred on the shelf between the speakers (mono, speakers in parallel);
  speaker leads (26-28 mm) come up through each speaker's vent hole.
- Pi 5 connector positions used (USB/Ethernet at -X, GPIO at the front): USB-C power
  X 31.3, micro-HDMI X 16.7 and 3.3 on the rear edge; camera connectors near X -2.5 and
  -15.5 at the rear.
