BennJo101/Gene_1.0/docs/images/render_carrier_v3.png

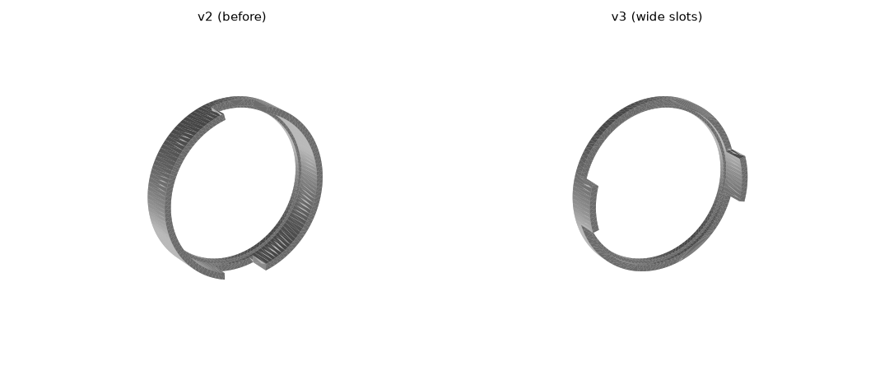
docs/images/render_carrier_v3.png
