BennJo101/Gene_1.0/cad/eye_display_carrier.stl

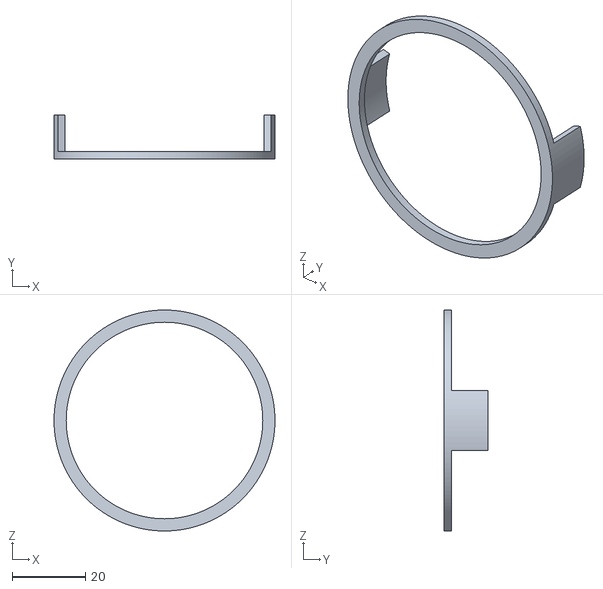
[picture p5: CAD file, 2026-10-30]
cad/eye_display_carrier.stl
60.5 x 12.0 x 60.5
