BennJo101/Gene_1.0/cad/mocks/i2s_amp.stl

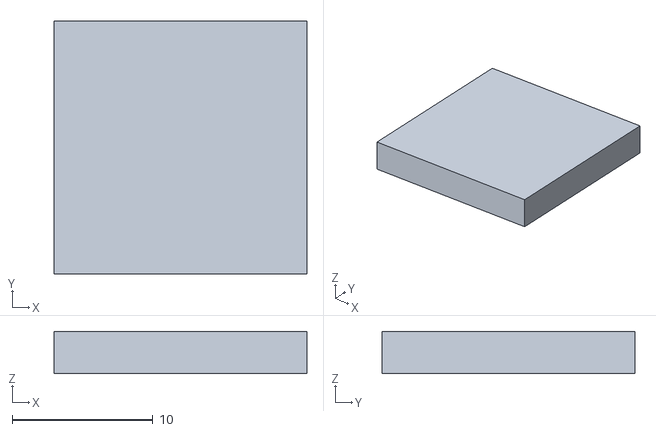
[picture p6: CAD file, 2026-10-16]
cad/mocks/i2s_amp.stl
18.0 x 18.0 x 3.00
