BennJo101/Gene_1.0/print/plates/tree_supports/Plate5_crown_insert_handle_tree_supports.3mf

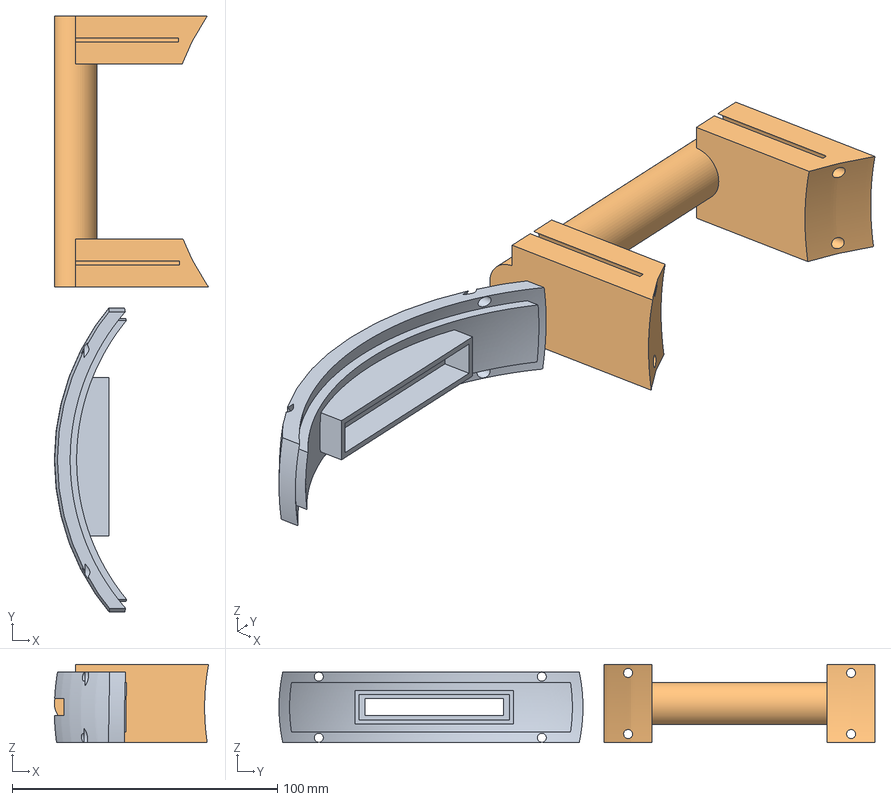
[picture p8: CAD file, 2026-10-30]
print/plates/tree_supports/Plate5_crown_insert_handle_tree_supports.3mf
58.1 x 224.5 x 29.4 mm
crown_insert_1
bridge_handle_2
