BennJo101/Gene_1.0/cad/mocks/pi5.stl

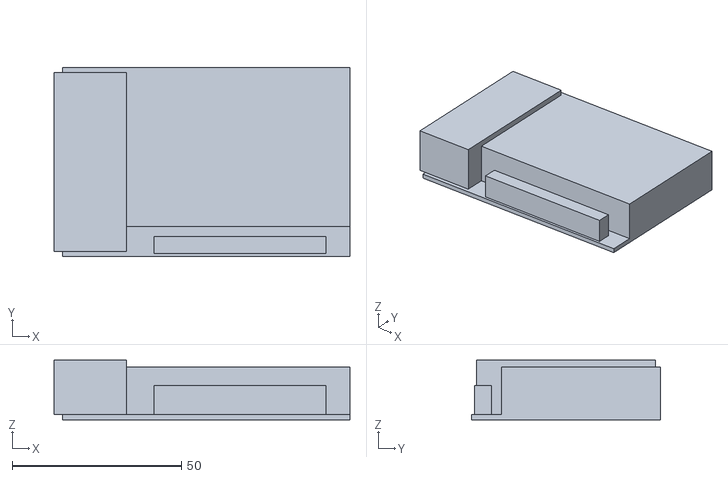
[picture p9: CAD file, 2026-10-16]
cad/mocks/pi5.stl
87.5 x 56.0 x 17.6
