BennJo101/Gene_1.0/cad/skull.stl

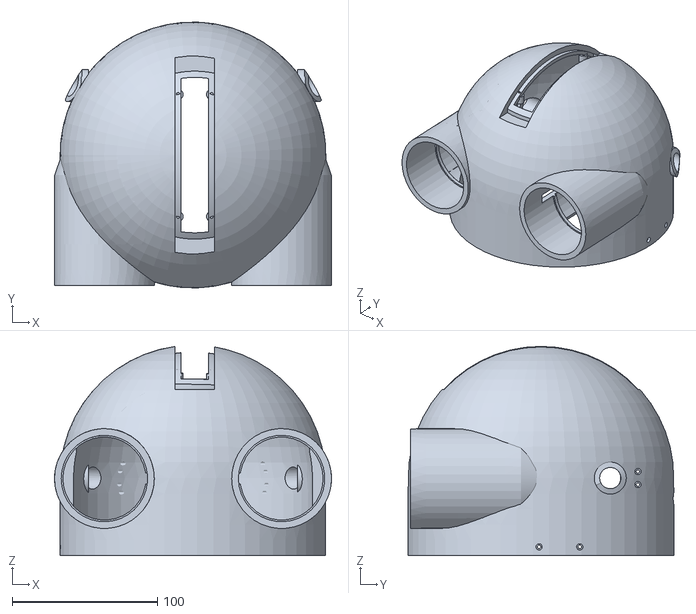
[picture p10: CAD file, 2026-10-30]
cad/skull.stl
190.6 x 182.8 x 144.0
