BennJo101/Gene_1.0/print/plates/Plate10_display_carriers.3mf

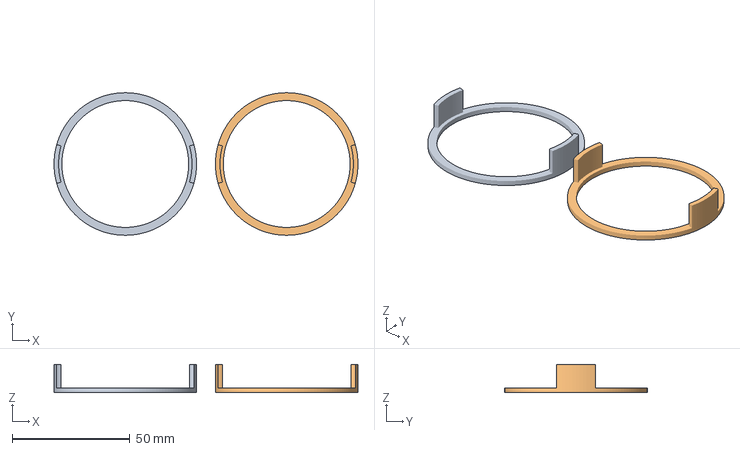
[picture p11: CAD file, 2026-10-30]
print/plates/Plate10_display_carriers.3mf
129.0 x 60.5 x 12.0 mm
carrier_1
carrier_2
