BennJo101/Gene_1.0/print/plates/tree_supports/Plate2_jaw_tree_supports.3mf

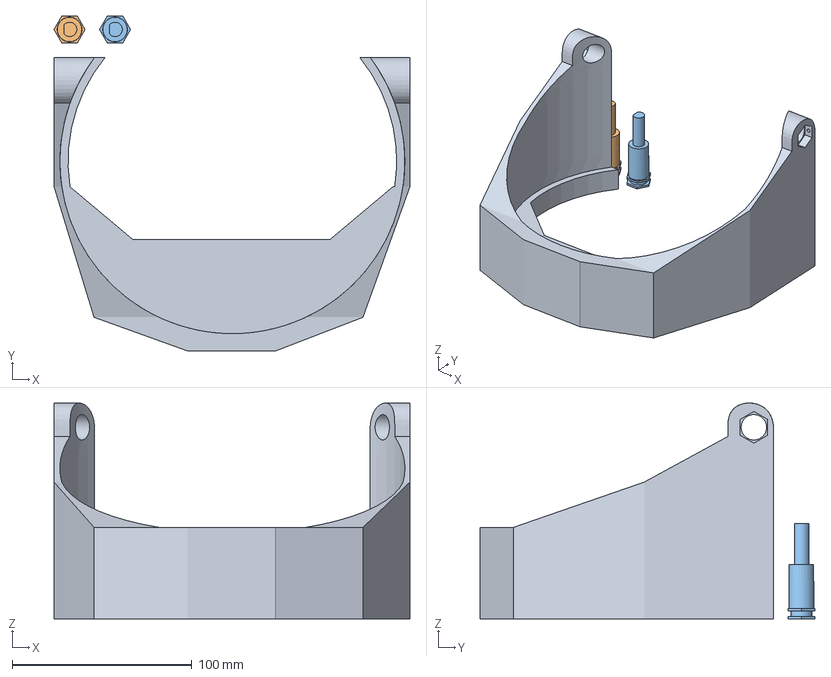
[picture p12: CAD file, 2026-10-30]
print/plates/tree_supports/Plate2_jaw_tree_supports.3mf
198.1 x 186.4 x 120.2 mm
jaw_1
jaw_pin_2
jaw_pin_3
