BennJo101/Gene_1.0/cad/jaw_pin.stl

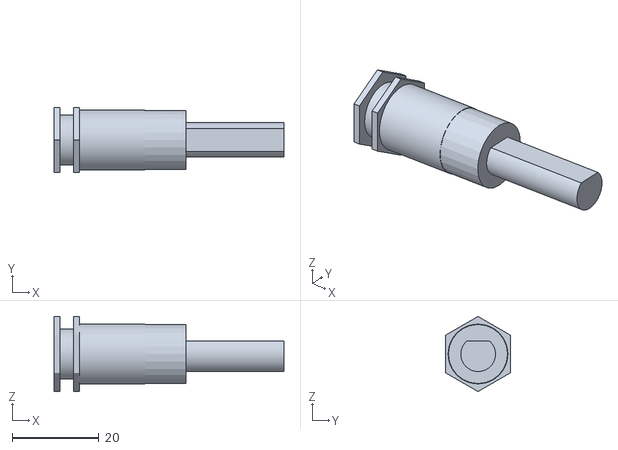
[picture p13: CAD file, 2026-10-29]
cad/jaw_pin.stl
53.0 x 15.0 x 17.3
