BennJo101/Gene_1.0/cad/mocks/ttl_interface.stl

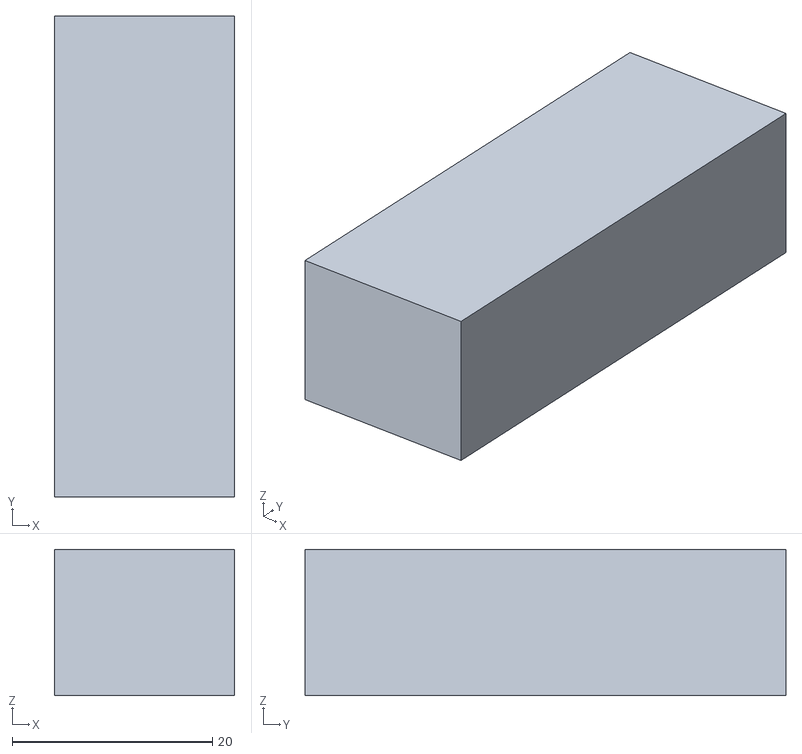
[picture p14: CAD file, 2026-10-16]
cad/mocks/ttl_interface.stl
18.0 x 48.0 x 14.6
