BennJo101/Gene_1.0/cad/jaw.stl

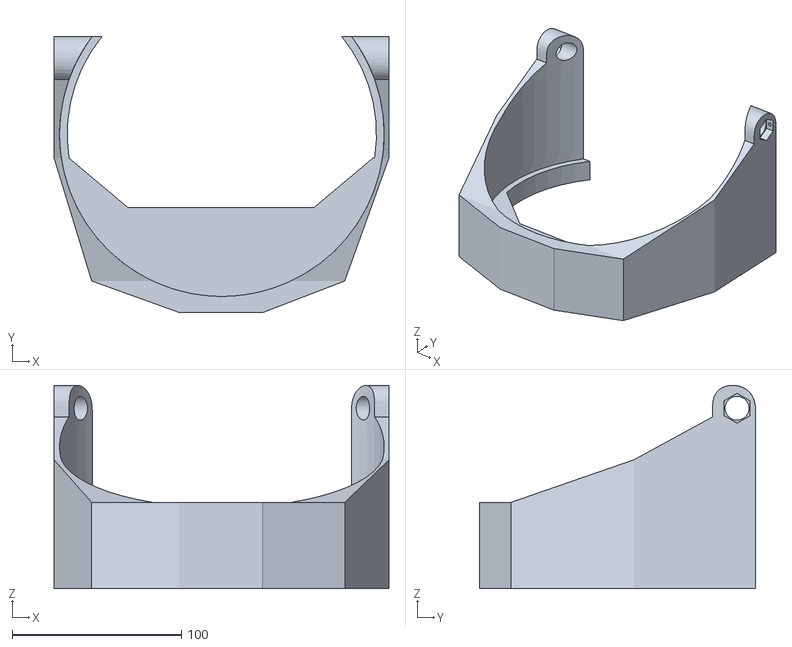
[picture p16: CAD file, 2026-10-29]
cad/jaw.stl
198.1 x 163.4 x 120.2
