BennJo101/Gene_1.0/cad/mocks/gpio_splitter.stl

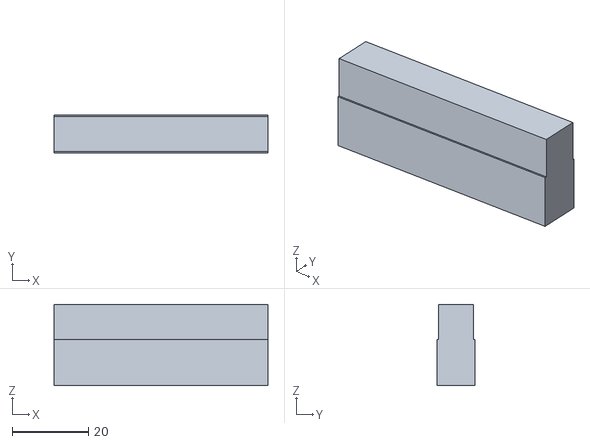
[picture p17: CAD file, 2026-10-16]
cad/mocks/gpio_splitter.stl
56.0 x 10.0 x 21.2
