BennJo101/Gene_1.0/print/plates/Plate4_small_parts.3mf

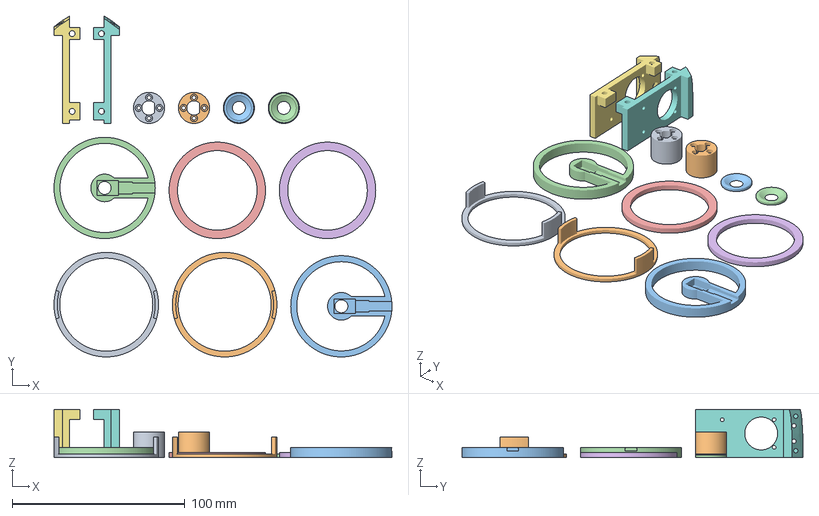
[picture p18: CAD file, 2026-10-30]
print/plates/Plate4_small_parts.3mf
195.6 x 197.3 x 28.0 mm
carrier_1
carrier_2
bezel_3
bezel_4
retainer_5
retainer_6
bracket_L_7
bracket_R_8
hub_9
hub_10
pupil_ring_11
pupil_ring_12
