BennJo101/Gene_1.0/cad/eye_x_insert.stl

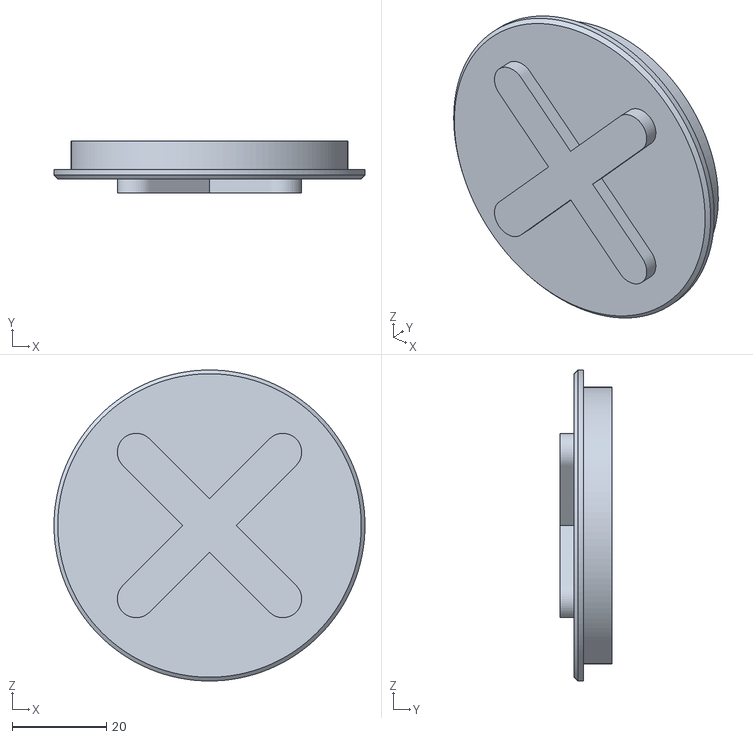
[picture p19: CAD file, 2026-10-16]
cad/eye_x_insert.stl
66.0 x 11.0 x 66.0
