BennJo101/Gene_1.0/cad/mocks/speakers.stl

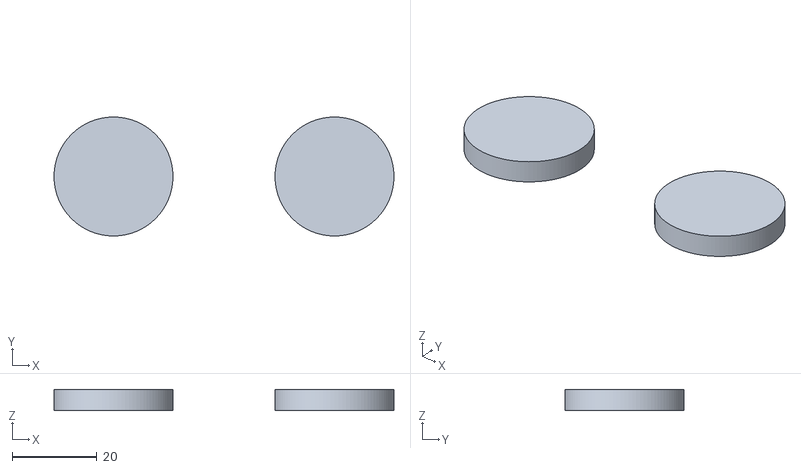
[picture p20: CAD file, 2026-10-16]
cad/mocks/speakers.stl
80.0 x 28.0 x 5.00
