BennJo101/Gene_1.0/print/parts/03_pi_shelf_x1.stl

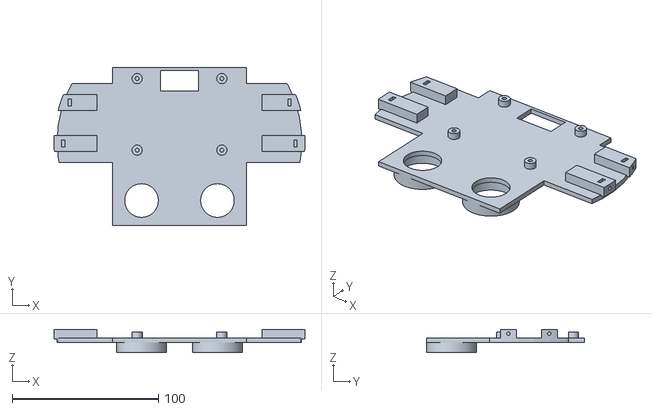
[picture p21: CAD file, 2026-10-16]
print/parts/03_pi_shelf_x1.stl
171.9 x 108.0 x 16.0
