BennJo101/Gene_1.0/cad/mocks/usbc_panel.stl

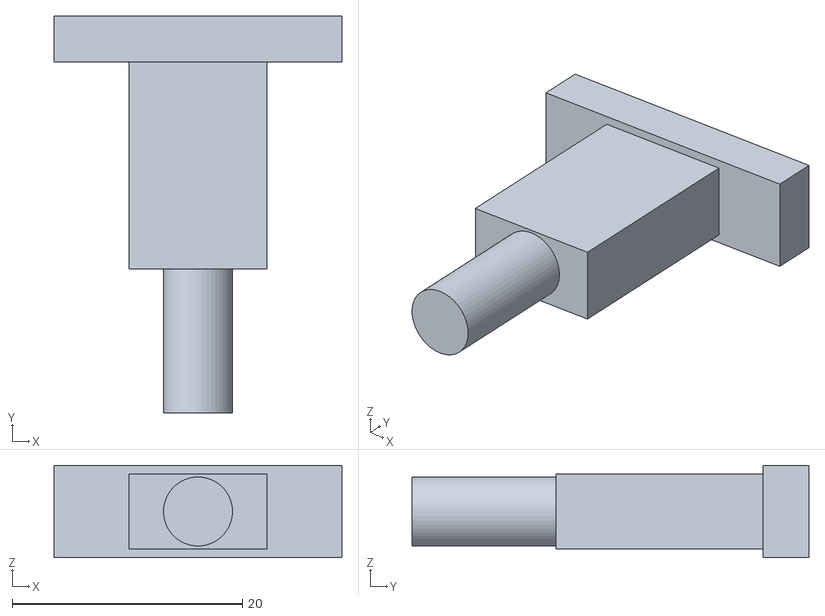
[picture p23: CAD file, 2026-10-08]
cad/mocks/usbc_panel.stl
25.0 x 34.5 x 8.00
