BennJo101/Gene_1.0/cad/mocks/neck_bearings.stl

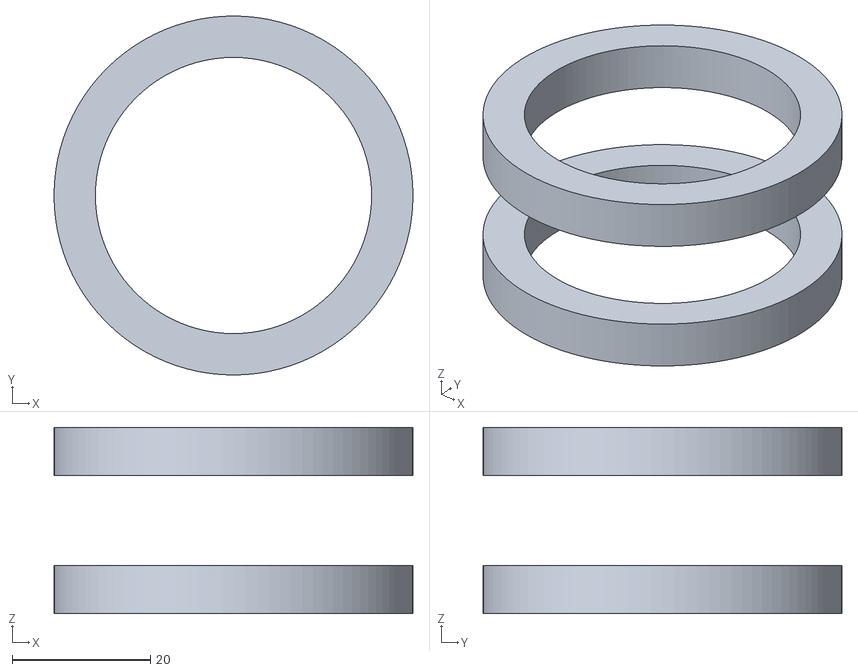
[picture p24: CAD file, 2026-10-06]
cad/mocks/neck_bearings.stl
52.0 x 52.0 x 27.0
