BennJo101/Gene_1.0/cad/servo_bracket_L.stl

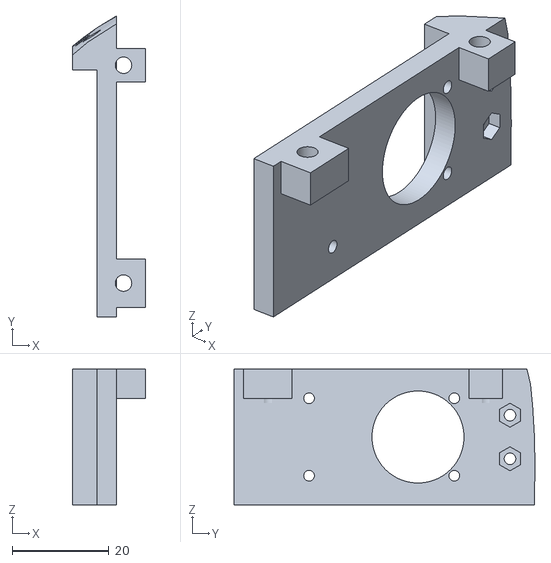
[picture p25: CAD file, 2026-10-08]
cad/servo_bracket_L.stl
15.0 x 62.2 x 28.0
