BennJo101/Gene_1.0/print/plates/Plate6_neck.3mf

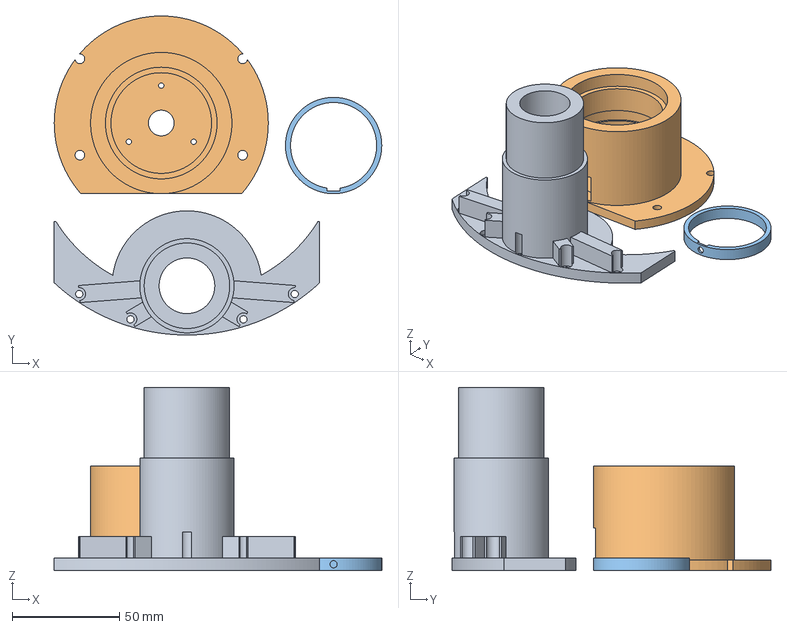
[picture p26: CAD file, 2026-10-06]
print/plates/Plate6_neck.3mf
153.0 x 149.0 x 85.7 mm
neck_1
neck_base_2
neck_collar_3
