BennJo101/Gene_1.0/cad/mocks/xl330_servo_R_placed.stl

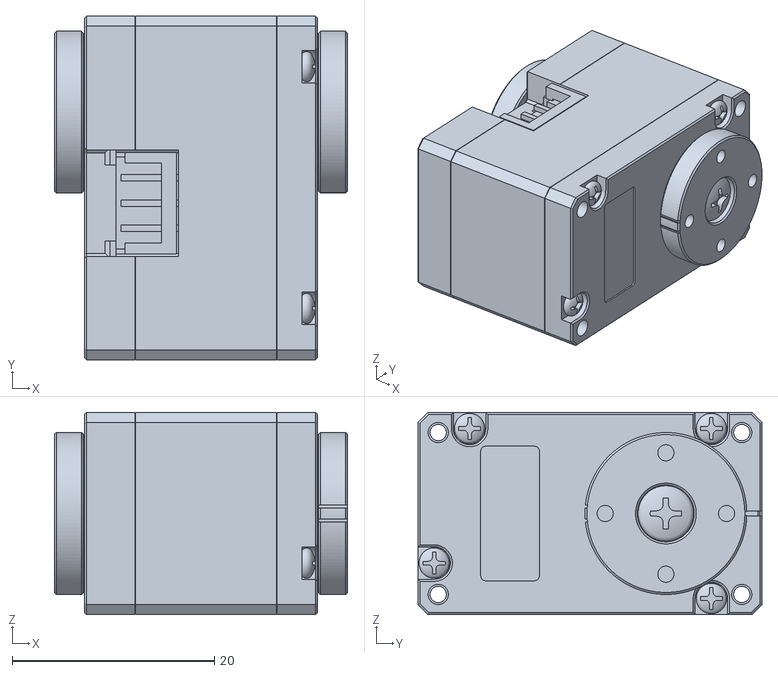
[picture p27: CAD file, 2026-10-06]
cad/mocks/xl330_servo_R_placed.stl
29.0 x 34.0 x 20.0
