BennJo101/Gene_1.0/cad/mocks/gpio_plug.stl

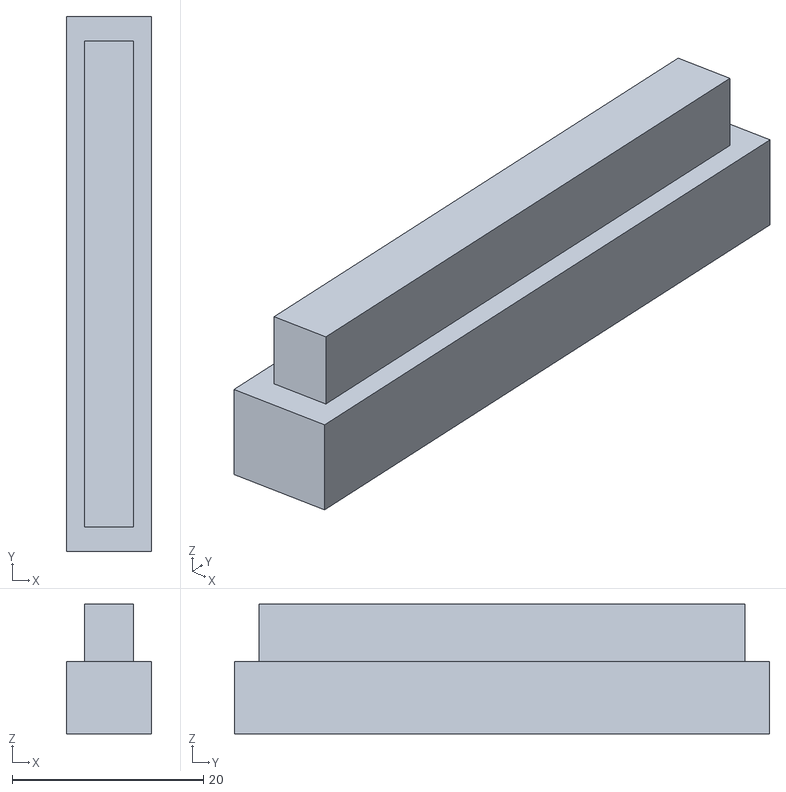
[picture p28: CAD file, 2026-10-06]
cad/mocks/gpio_plug.stl
8.90 x 56.0 x 13.6
