BennJo101/Gene_1.0/cad/neck.stl

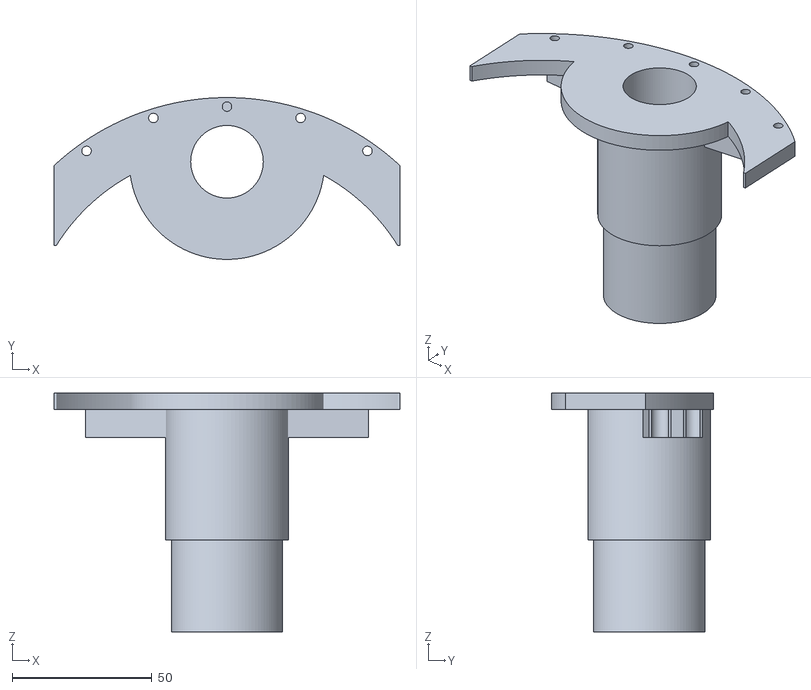
[picture p29: CAD file, 2026-10-06]
cad/neck.stl
124.0 x 58.0 x 85.7
