BennJo101/Gene_1.0/cad/gpio_cover.stl

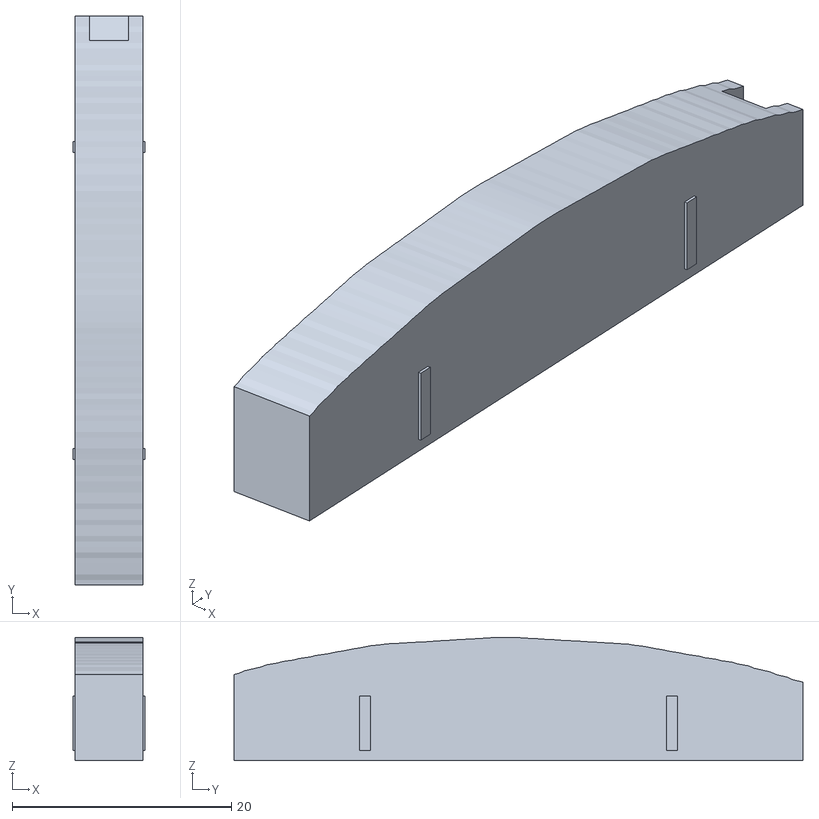
[picture p31: CAD file, 2026-10-06]
cad/gpio_cover.stl
6.60 x 51.9 x 11.2
