BennJo101/Gene_1.0/cad/mocks/display.stl

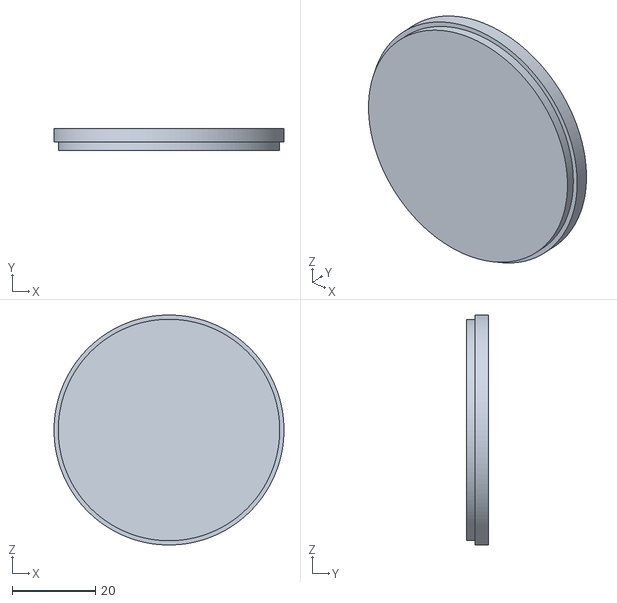
[picture p32: CAD file, 2026-10-06]
cad/mocks/display.stl
55.4 x 5.20 x 55.4
