BennJo101/Gene_1.0/print/parts/08_jaw_drive_hub_x2.stl

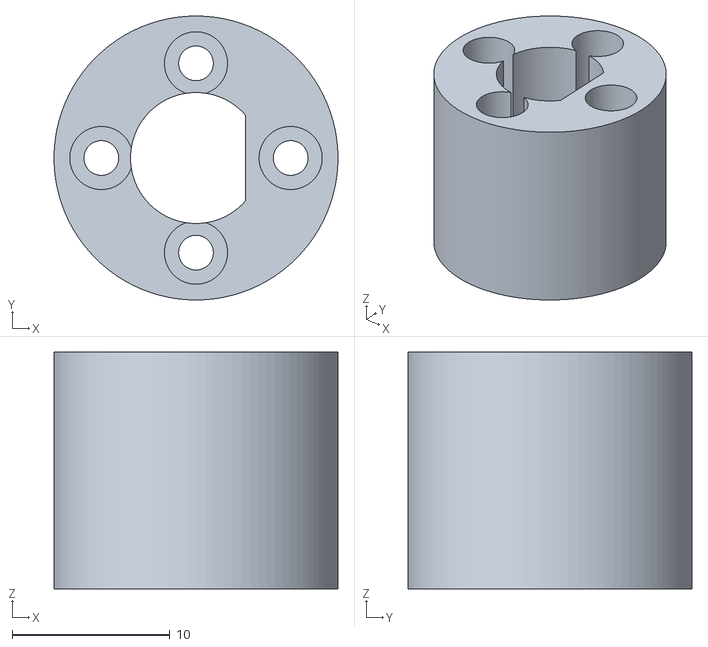
[picture p33: CAD file, 2026-10-06]
print/parts/08_jaw_drive_hub_x2.stl
18.0 x 18.0 x 15.0
