BennJo101/Gene_1.0/cad/camera_bezel.stl

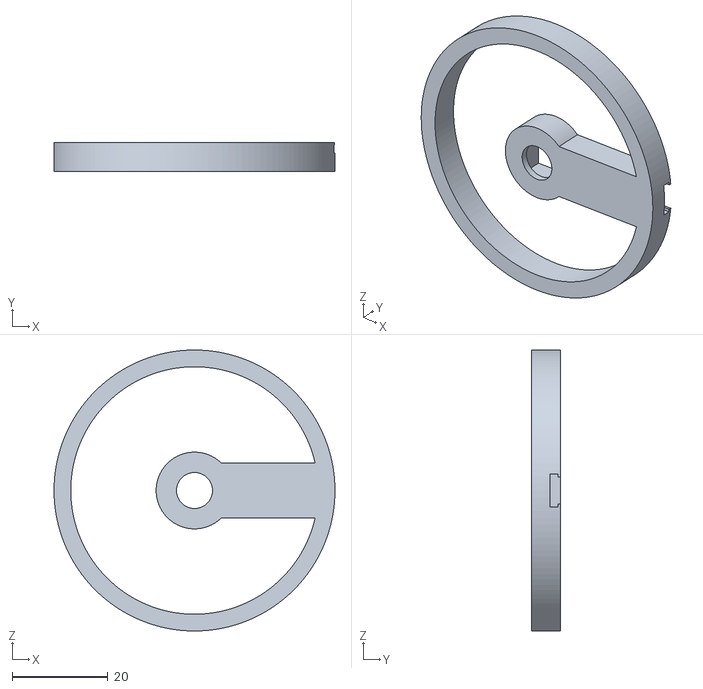
[picture p34: CAD file, 2026-10-06]
cad/camera_bezel.stl
58.6 x 6.00 x 58.6
