BennJo101/Gene_1.0/cad/mocks/camera.stl

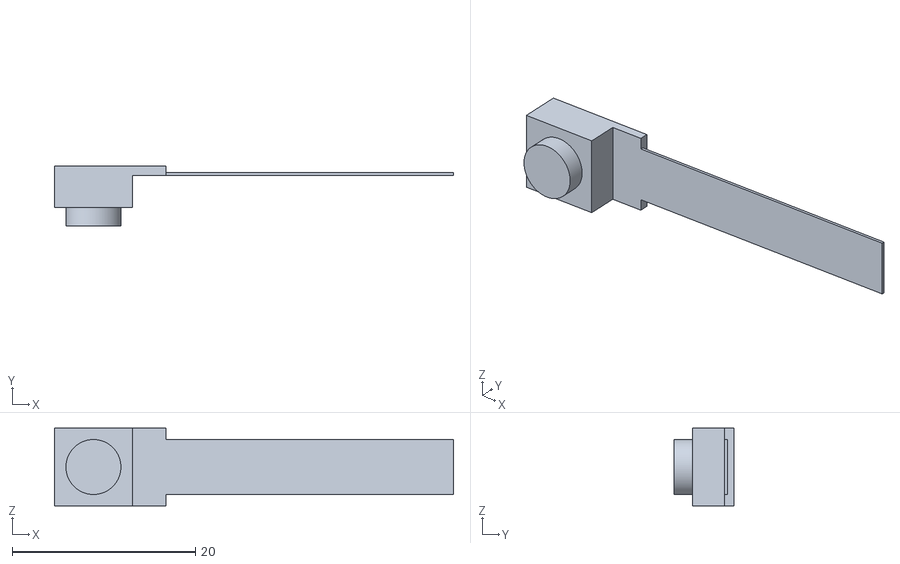
[picture p35: CAD file, 2026-10-06]
cad/mocks/camera.stl
43.5 x 6.50 x 8.50
