BennJo101/Gene_1.0/cad/mocks/display_driver_board.stl

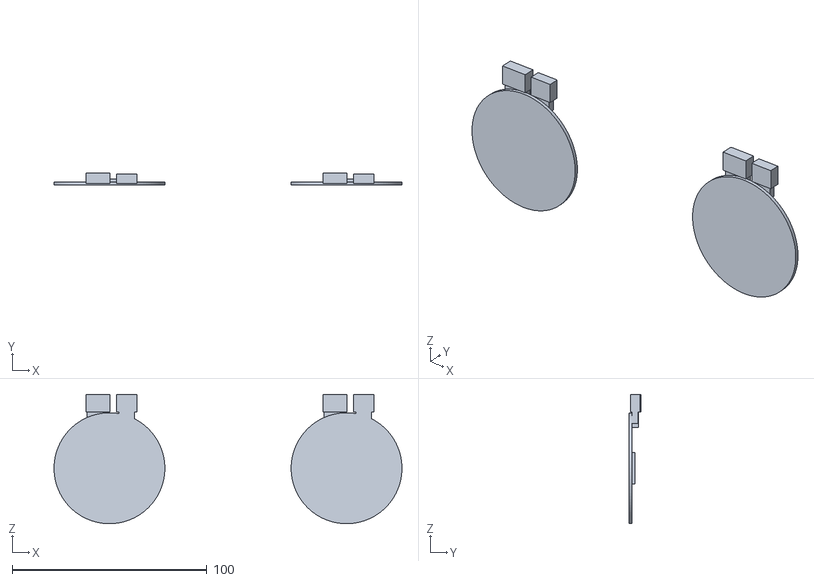
[picture p37: CAD file, 2026-10-06]
cad/mocks/display_driver_board.stl
178.9 x 6.20 x 66.5
