BennJo101/Gene_1.0/print/parts/16_neck_collar_x1.stl

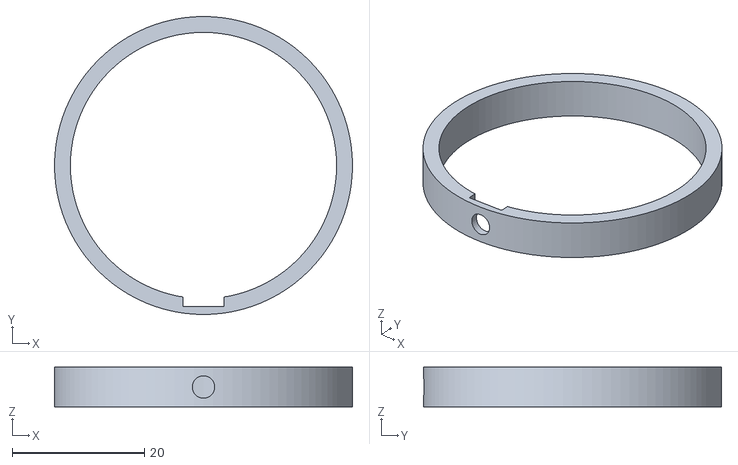
[picture p38: CAD file, 2026-10-06]
print/parts/16_neck_collar_x1.stl
45.0 x 45.0 x 6.00
