BennJo101/Gene_1.0/cad/battery_tray.stl

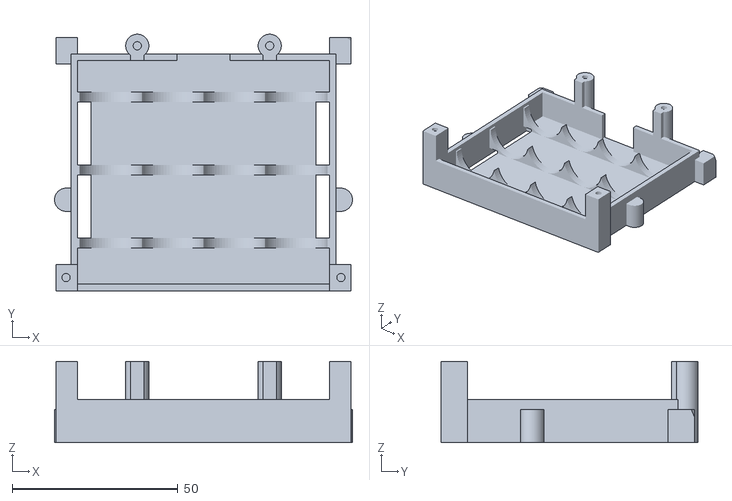
[picture p39: CAD file, 2026-10-06]
cad/battery_tray.stl
90.0 x 77.5 x 24.5
