BennJo101/Gene_1.0/cad/mocks/power_boards.stl

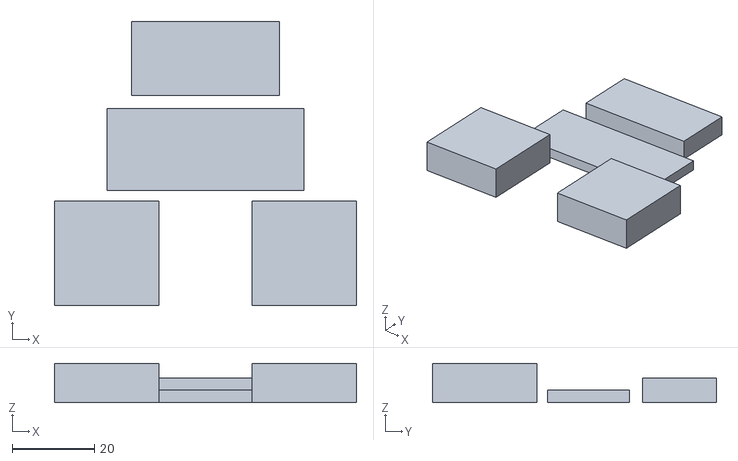
[picture p40: CAD file, 2026-10-06]
cad/mocks/power_boards.stl
73.4 x 69.0 x 9.50
