BennJo101/Gene_1.0/print/parts/12_pupil_ring_x2.stl

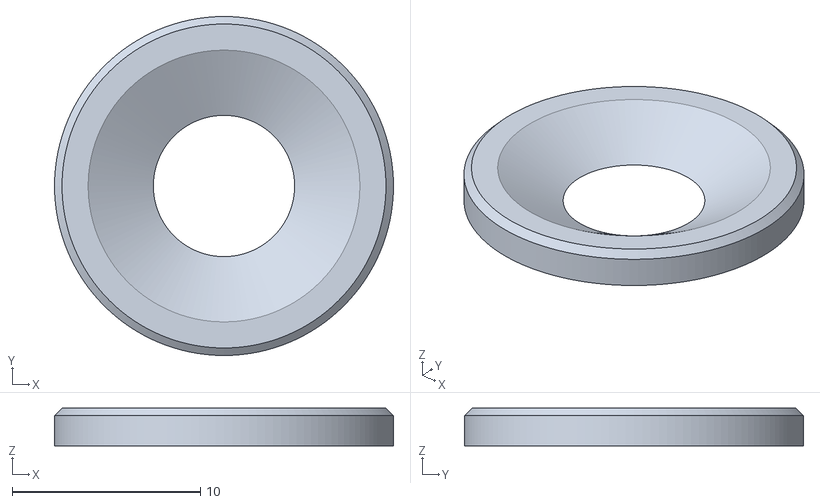
[picture p41: CAD file, 2026-10-06]
print/parts/12_pupil_ring_x2.stl
18.0 x 18.0 x 2.00
