BennJo101/Gene_1.0/cad/bridge_handle.stl

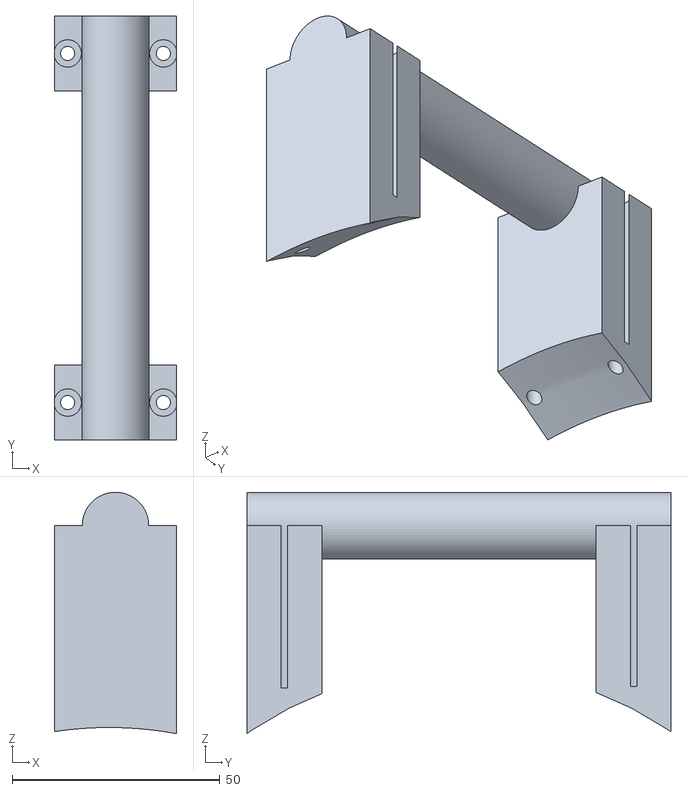
[picture p42: CAD file, 2026-10-06]
cad/bridge_handle.stl
29.4 x 102.0 x 58.1
