BennJo101/Gene_1.0/cad/battery_deck.stl

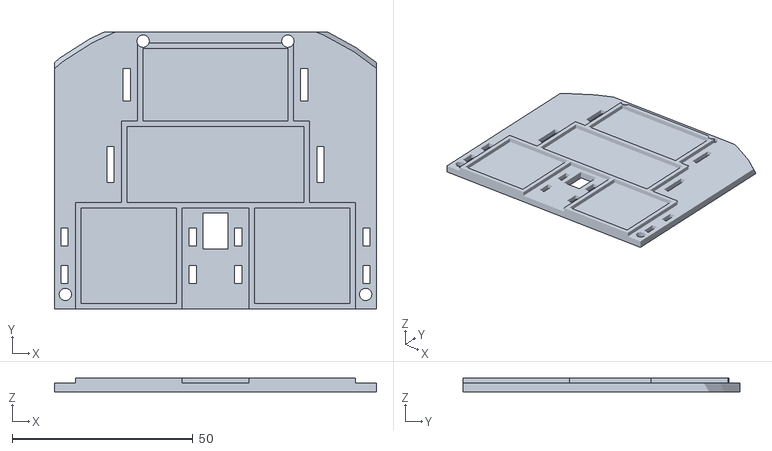
[picture p43: CAD file, 2026-10-06]
cad/battery_deck.stl
89.0 x 76.5 x 4.00
