BennJo101/Gene_1.0/cad/mocks/battery_2S2P.stl

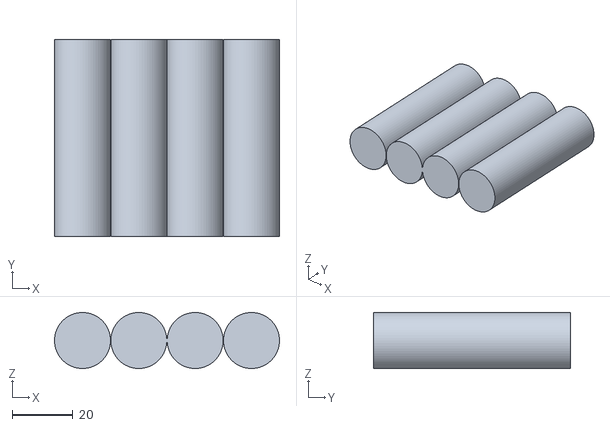
[picture p44: CAD file, 2026-10-06]
cad/mocks/battery_2S2P.stl
74.3 x 65.0 x 18.5
