BennJo101/Gene_1.0/print/parts/10_eye_display_retainer_x2.stl

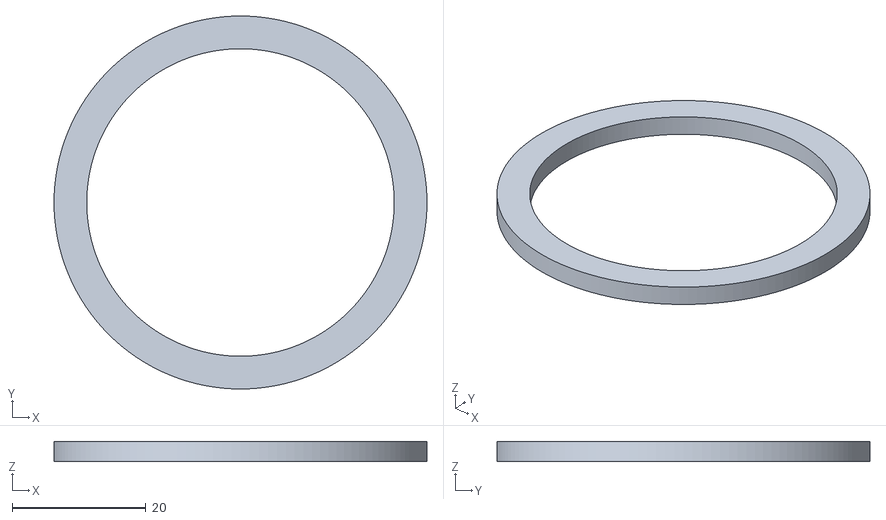
[picture p46: CAD file, 2026-10-06]
print/parts/10_eye_display_retainer_x2.stl
55.8 x 55.8 x 3.00
