BennJo101/Gene_1.0/cad/mocks/slip_ring.stl

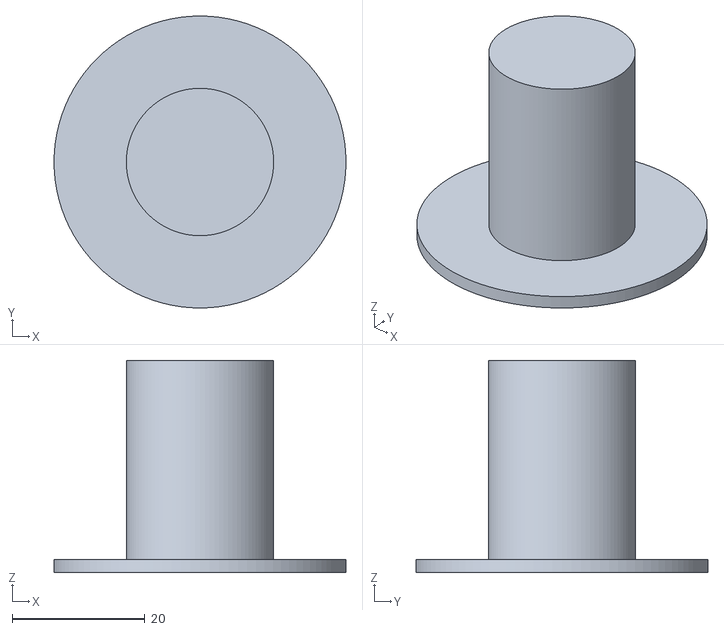
[picture p47: CAD file, 2026-10-06]
cad/mocks/slip_ring.stl
44.0 x 44.0 x 32.0
