BennJo101/Gene_1.0/cad/neck_base.stl

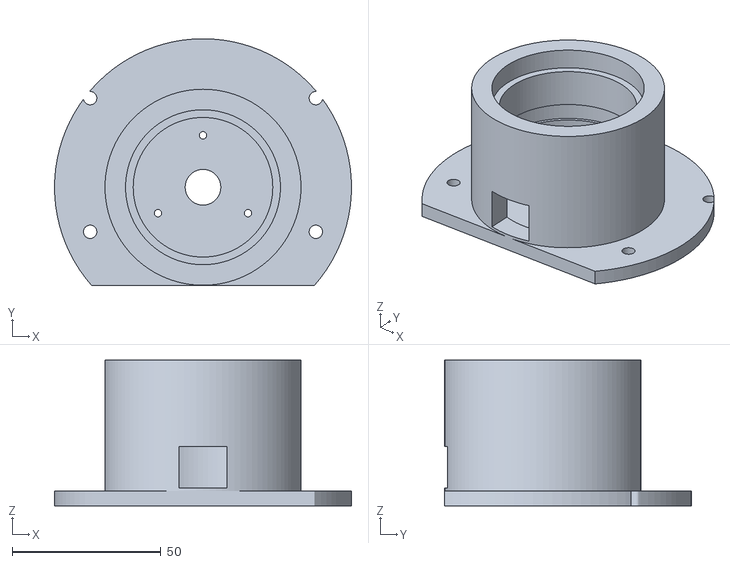
[picture p48: CAD file, 2026-10-06]
cad/neck_base.stl
100.0 x 83.0 x 49.0
