BennJo101/Gene_1.0/(list of files, cad)

Other CAD files:
print/parts/09_eye_display_carrier_x2.stl
print/parts/01_skull_x1.stl
print/parts/23_jaw_pin_x2.stl
print/plates/Plate1_skull.3mf
print/parts/02_jaw_x1.stl
print/plates/tree_supports/Plate8_changes_2026-10-16_tree_supports.3mf
print/plates/Plate2_jaw.3mf
cad/pi_shelf.stl
print/parts/20_eye_x_insert_OPTIONAL_x1.stl
print/plates/Plate3_shelf_battery.3mf
print/plates/tree_supports/Plate1_skull_tree_supports.3mf
print/parts/07_servo_bracket_R_x1.stl
cad/servo_bracket_R.stl
print/parts/06_servo_bracket_L_x1.stl
print/plates/Plate7_gpio_flashlight_cover.3mf
print/plates/Plate5_crown_insert_handle.3mf
cad/gpio_flashlight.stl
cad/mocks/xl330_servo.stl
print/parts/17_bridge_handle_OPTIONAL_x1.stl
cad/mocks/jaw_drive_hub_R_placed.stl
print/parts/05_battery_deck_x1.stl
cad/pupil_ring.stl
print/parts/11_camera_bezel_x2.stl
cad/jaw_drive_hub.stl
cad/crown_insert.stl
print/parts/14_neck_x1.stl
cad/eye_display_retainer.stl
print/parts/04_battery_tray_x1.stl
cad/neck_collar.stl
print/parts/19_gpio_cover_OPTIONAL_x1.stl
print/parts/15_neck_base_x1.stl
cad/tools/retired/carrier_v3_before_seat_ease.stl
cad/tools/retired/jaw_v4_before_screw_pins.stl
cad/tools/retired/pi_shelf_before_cubes.stl
cad/tools/retired/speakers_before_drop.stl
