BennJo101/Gene_1.0/(commit log)

2026-10-06 Pushing All 1.0
    [01_skull_x1.stl, 02_jaw_x1.stl, 03_pi_shelf_x1.stl, 04_battery_tray_x1.stl, 05_battery_deck_x1.stl, 06_servo_bracket_L_x1.stl, 07_servo_bracket_R_x1.stl, 08_jaw_drive_hub_x2.stl]
2026-10-08 Skull v7: shelf nut posts, horizontal USB-C port; simplify file names
    - Skull: 4 nut posts on the inner wall for the Pi shelf wings (M2 x 8 up
    through each wing into a side-loaded M2 nut); the old M3 self-tappers
    had nothing to bite. TTL interface now rests on the left posts.
    - USB-C charge port turned 90 deg (flange horizontal, screws side by side).
    - Servo brackets through-bolted with M2; jaw pivot-screw holes filled.
    - Wiring doc with audio and power diagrams.
    - Removed old skull/part versions and the Plate 8/9 reprint plates.
    - Renamed model files to plain part names (skull.stl, jaw.stl, ...);
    fit-check stand-ins moved to cad/mocks/; sim is sim/head_sim.html.
    - Regenerated print pa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
    [01_skull_x1.stl, 02_jaw_x1.stl, 06_servo_bracket_L_x1.stl, 07_servo_bracket_R_x1.stl, BOM.csv, GeneBottom_v4_twindrive.stl, GeneHead_ttl_interface_MOCK.stl, GeneHead_xl330_bracket_R_v2.stl]
2026-10-08 README: new head renders (cover, neck + cover, handle)
    Replace the three old renders with the current skull: head with the GPIO
    cover and no handle, head on the neck with the cover, and head with the
    bridge handle and no neck.
2026-10-14 Add Gene's Pi software (software/pi/gene)
    A snapshot of ~/gene from the Pi at fd024f5: the voice loop, brain, Piper voice, eyes, cameras, memory, self-upgrade
    system and the new web control panel (live eyes and ears, face, say, mouth, live Claude Code upgrades). Network names
    and IPs in the docs are placeholders; state, models, the venv and secrets are not included.
2026-10-16 Shelf divots, lowered Pi/speaker shelf, bracket M3 pilots, eye X insert
    - Pi/speaker shelf drops 13.35 mm so its plate is flush with the skull's
    bottom rim; the speaker cradles poke out below. 4 cubes on the wings
    slide up into divots in the skull wall and bolt in from outside
    (M2 x 12 + nut). Replaces the skull's nut posts.
    - Skull gets the missing pilots for the bracket M3 self-tappers.
    - Optional Halloween eye cap with a raised X (either eye).
    - Mocks, cable routes, print parts, Plates 1/3 and a combined Plate 8
    (skull + shelf + eye insert, 350 mm bed) regenerated; docs updated.
    Claude-Session: https://claude.ai/code/session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
    [01_skull_x1.stl, 03_pi_shelf_x1.stl, 20_eye_x_insert_OPTIONAL_x1.stl, BOM.csv, Plate1_skull.3mf, Plate3_shelf_battery.3mf, Plate8_changes_2026-10-16.3mf, eye_x_insert.stl]
2026-10-16 Wiring: 2S2P pack build diagram, power diagram updates, 2-wire switch
    - New wiring_pack.svg (building the 2S2P pack) linked from WIRING.md.
    - Power diagram and table updated; the power switch is 2-wire, in the
    BMS + line only, with no ground connection.
    Claude-Session: https://claude.ai/code/session_01KQzj1zTRsSUmH8NUoGxzqV
2026-10-25 Docs and wiring updates: BOM, wiring diagrams, README; archive retired STLs
    - docs: BOM, wiring, README updates; new wiring_loads.svg
    - cad/tools/retired: archived pre-change STLs
    [BOM.csv, pi_shelf_before_cubes.stl, speakers_before_drop.stl]
2026-10-29 Jaw v5: screw-in pivot pins instead of pins printed on the jaw
    The jaw's pivot pins and D-shafts had to pass axially through the closed
    skull socket, so fitting the jaw meant springing the arms apart and the
    pins snapped. They are now separate parts:
    - cad/tools/jaw_screw_pins.py: cuts the pins off the v4 jaw into
    jaw_pin.stl (hex head AF 15, original bearing pin and D-shaft) and
    gives each arm a hex pocket, a 14.1 bore and an M3 grub hole that
    locks the pin through a groove in its head
    - the bare jaw now slides on from below with no contact; pins go in
    from outside through the arm and socket into the hubs
    - parts/check/sweep/export/printprep/plates include the pins; fits and
    jaw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
    [02_jaw_x1.stl, 23_jaw_pin_x2.stl, BOM.csv, Plate2_jaw.3mf, jaw.stl, jaw_pin.stl, jaw_v4_before_screw_pins.stl]
2026-10-29 mass.py: give the USB-C port a weight so the weights update again
    usbc_port had no mass, so mass.py stopped before writing anything.
    Design notes weight and torque figures refreshed (1324 g; jaw + hubs +
    pins 281 g) and the sim rebuilt.
2026-10-30 Skull and eye carrier fixes, optional tree-support plates, tougher jaw pins
    Skull (rim-down print, outside unchanged; checked with rays from 13 directions):
    - skull_v7_eye_plate_window.py: the flat plate between the eye barrels is cut to a
    U (6 mm strips along both barrels and the face, open at the back), so far fewer
    supports under it
    - skull_v7_shorten_tabs.py: inboard barrel tabs behind the camera slots cut to half
    their length (end at Y -74.45)
    - skull_v7_ledge_relief.py: relief inside the top of each barrel for the LCD's flex
    ledge, keeping ~1.1 mm of wall under the skin
    - 574.0 cm3, one watertight solid, part overlaps unchanged
    Eye display carrier (screens showed pressure mark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
    [01_skull_x1.stl, 09_eye_display_carrier_x2.stl, Plate10_display_carriers.3mf, Plate1_skull.3mf, Plate1_skull_tree_supports.3mf, Plate2_jaw_tree_supports.3mf, Plate3_shelf_battery_tree_supports.3mf, Plate4_small_parts.3mf]
2026-10-30 Sims and weights: today's skull and display carriers
    - web/skull.json, web/carrier.json re-exported; sim/head_sim.html rebuilt (only those
    two and mass.json changed)
    - mass.py rerun: 1316 g (head 1035 g, jaw + hubs + pins 281 g); torques unchanged to
    0.01 N.m. Design notes updated
